ignaciosamba/PPS/informes/Informe200horas/tex/introduccion.tex

\section{Introducci\'on} % (fold)
\label{sec:introduccion}

Esta practica fue orientada al dise\~no y la construcci\'on de un sistema embebido que concentre las se\~nales de varios sensores y varias fuentes de eventos digitales. La idea es que un sistema embebido de uso especifico pueda tercerizar la tarea de obtener, convertir y procesar una se\~nal de uno o varios sensor o una o varias fuente de eventos digitales.

Este proyecto surgi\'o de la problem\'atica de algunos trabajos realizados dentro del Laboratorio de Arquitectura de Computadoras que compart\'ian el mismo inconveniente. La necesidad de un sistema que gen\'ericamente obtenga las se\~nales de los sensores y la pueda transmitir al sistema principal, ya convertidas. Adem\'as de un contador de eventos que no requiera del uso de interrupciones por software.

En este informe cubrimos los avances hechos en 200 horas de trabajo en el proyecto.
% section introducci\'on (end)
