ignaciosamba/PPS/informes/Informe 200 horas from Overleaf/practica-profesional-supervisada/tex/introduccion.tex

\section{Introducción} % (fold)
\label{sec:introduccion}

Esta práctica fue orientada al diseño y la construcción de un sistema embebido que concentre las señales de varios sensores y varias fuentes de eventos digitales. La idea es que un sistema embebido de uso específico pueda tercerizar la tarea de obtener, convertir y procesar una señal de uno o varios sensor o una o varias fuente de eventos digitales.

Este proyecto surgió de la problemática de algunos trabajos realizados dentro del Laboratorio de Arquitectura de Computadoras que compartían el mismo inconveniente. La necesidad de un sistema que genéricamente obtenga las señales de los sensores y la pueda transmitir al sistema principal, ya convertidas. Además de un contador de eventos que no requiera del uso de interrupciones por software.

En este informe cubrimos los avances hechos en 200 horas de trabajo en el proyecto.
% section introducción (end)
