ignaciosamba/PPS/informes/Informe 100 horas/tex/apendices/softwareUtilizado.tex

\section{Sofware Utilizado} % (fold)
\label{sec:sofware_utilizado}

\subsubsection{$\mu$Vision 4} % (fold)
\label{ssub:uvision_4}

$\mu$Vision 4 es un entorno de desarrollo de programacion desarrollado por KeilARM. Esta pensado para construccion de programas en C destinados a correr sobre sistemas embebidos, como es el caso de una Silicon Labs C8051F350. Confecciona todos los archivos fuente de un proyecto y los arma en un unico ejecutable, que luego puede cargarse al microcontrolador para su ejecucion. Tambien permite la opcion de debuggear. \\

\textbf{Mas informacion:}$\mu$Vision IDE Overview ( http://www.keil.com/uvision/default.asp )

% subsubsection uvision_4 (end)

\subsection{KiCad} % (fold)
\label{sub:kicad}

Kicad es una herramienta de software abierto que permite crear circuitos electronicos desde la etapa de dise\~no hasta la implementacion en circuito impreso. Permite la generacion de los archivos necesarios para generar la placa PCB impresa utilizando una fresadora o ruteadora.  \\

\textbf{Mas informacion:} KiCad EDA: A Cross Platform and Open Source Electronics Design Automation Suite ( http://kicad-pcb.org/help/documentation )

% subsection kicad (end)

% section sofware_utilizado (end)
