ignaciosamba/PPS/Placa Operacional/Impresion/herramientas.rtf

Perforación

Creado satisfactoriamente para las capas:
DrillUnplated

Atención, no hay objetos en las capas:
DrillPlated

Herramientas necesarias

Herramientas de perforación:
1 x Spiral Drill 1 mm ( 32 strokes )
1 x Spiral Drill 1,5 mm ( 5 strokes )
1 x Spiral Drill 1,8 mm ( 2 strokes )
1 x Spiral Drill 0,9 mm ( 29 strokes )

Fresa de contorneado:
1 x Contour Router 1 mm ( 11,2 mm )

Herramientas cónicas:
1 x Universal Cutter 0,2 mm ( 68,0 mm )
