ignaciosamba/PPS/informes/Informe 100 horas/main.tex

%%%%%%%%%%%%%%%%%%%%%%%%%%%%%%%%%%%%%%%%%%%%%%%%%%%%%%%%%%%%%%%%%%%%%%%%%%%
%
% Plantilla para un artículo en LaTeX en espa\~nol.
%
%%%%%%%%%%%%%%%%%%%%%%%%%%%%%%%%%%%%%%%%%%%%%%%%%%%%%%%%%%%%%%%%%%%%%%%%%%%

\documentclass{article}

% Esto es para poder escribir acentos directamente:
\usepackage[utf8]{inputenc}
\inputencoding{latin1}

% Esto es para que el LaTeX sepa que el texto está en espa\~nol:
\usepackage[spanish]{babel}
% Esto es para que se pueda crear el indice
%\usepackage{makeidx}
% Paquetes de la AMS:
\usepackage{amsmath, amsthm, amsfonts}
% para poder poner una hoja apaisada
\usepackage{lscape}
%para incluir graficos
\usepackage{graphicx}
%para permitir que la imagen este donde yo quiero y no en otro lugar
\usepackage{float}
% para hipertexto
\usepackage{url}
% para poder envolver imagenes con texto
\usepackage{wrapfig}
%para los apendices
\usepackage[titletoc]{appendix}
% Esto es para poder modificar las dimensiones del texto
\usepackage{geometry}
\geometry{a4paper}

% Paquetes de la AMS:
\usepackage{amsmath, amsthm, amsfonts}

\graphicspath{ {Imagenes/} }

% Teoremas
%--------------------------------------------------------------------------
\newtheorem{thm}{Teorema}[section]
\newtheorem{cor}[thm]{Corolario}
\newtheorem{lem}[thm]{Lema}
\newtheorem{prop}[thm]{Proposición}
\theoremstyle{definition}
\newtheorem{defn}[thm]{Definición}
\theoremstyle{remark}
\newtheorem{rem}[thm]{Observación}

% Atajos.
% Se pueden definir comandos nuevos para acortar cosas que se usan
% frecuentemente. Como ejemplo, aquí se definen la R y la Z dobles que
% suelen representar a los conjuntos de números reales y enteros.
%--------------------------------------------------------------------------

\def\RR{\mathbb{R}}
\def\ZZ{\mathbb{Z}}

% De la misma forma se pueden definir comandos con argumentos. Por
% ejemplo, aquí definimos un comando para escribir el valor absoluto
% de algo más fácilmente.
%--------------------------------------------------------------------------
\newcommand{\abs}[1]{\left\vert#1\right\vert}
\newcommand{\summary}[1]{\addtocontents{toc}{#1\par}}

% Operadores.
% Los operadores nuevos deben definirse como tales para que aparezcan
% correctamente. Como ejemplo definimos en jacobiano:
%--------------------------------------------------------------------------
\DeclareMathOperator{\Jac}{Jac}

%--------------------------------------------------------------------------
\title{\underline{Practica Profesional Supervisada} \\
\large \underline{Informe de las 100 horas} \\
\huge \textbf{ \\ Plataforma Concentradora de Sensores y Eventos Digitales} \\ }
\author{Autores: Ignacio Sambataro, Luciano Mantovani\\ \\
  \large Tutor: PhD. Ing. Orlando Micolini \\
  \large Supervisor: Ing. Maximiliano Eschoyez
 % \small Facultad de Ciencias Exactas, Fisicas y Naturales\\
 % \small Laboratorio de Arquitectura de Computadoras\\
 % \small Universidad Nacional de Cordoba\\
  \date{}
}

%\makeindex
\begin{document}
\maketitle
\begin{figure}[H]
\centering

\end{figure}

\begin{center}
\small Facultad de Ciencias Exactas, Físicas y Naturales
\end{center}

\begin{center}
\small Laboratorio de Arquitectura de Computadoras
\end{center}

\begin{center}
\small Año 2015 \\
\end{center}

%resumen
\abstract{En este informe se describen las primeras 100 horas de trabajo de la Práctica Profesional Supervisada. Se comenzó un proyecto nuevo, sugerido por el director, Orlando Micolini, y se trabajo todo el tiempo en el Laboratorio de Arquitectura de Computadoras. Se documentaron los requerimientos, la etapa de investigación, los diseños de hardware y software hasta el momento, y las implementaciones que se llegaron a lograr. Lo que se llego a implementar se hizo en una placa de desarrollo prestada. Las razones de utilización de esta placa se explican en el documento. Algunos requerimientos básicos llegaron a cumplirse dentro de las 100 horas, pero solamente prototipos de prueba en la placa de desarrollo. El primer prototipo real tiene la mayor parte del diseño de hardware y software hecho, pero todavía no esta implementado. }

%salto de pagina
\thispagestyle{empty}
\clearpage

\tableofcontents
\thispagestyle{empty}
\clearpage

\setcounter{page}{1}
%introduccion
\input{./tex/introduccion.tex}

%requerimientos
\input{./tex/requerimientos.tex}

%investigacion
\input{./tex/investigacion.tex}

%Silicon Labs C8051F352
\input{./tex/siliconlabs.tex}

%Diseño de Software
\input{./tex/softdesign.tex}

%Diseño de Hardware
\input{./tex/harddesign.tex}

%Estructura de Software
\input{./tex/softstruct.tex}

%Avances con respecto al diseño de hw y sw
\input{./tex/avances.tex}

%Proyecciones con respecto al futuro
\input{./tex/proyecciones.tex}

%conclusiones
\input{./tex/conclusiones.tex}

%Apendice
\input{./tex/appendix.tex}

%Bibliografia
\input{./tex/bibliografia.tex}

%\begin{equation}\label{eq:area}
%  S = \pi r^2
%\end{equation}
%Uno puede referirse a ecuaciones así: ver ecuación (\ref{eq:area}).
%También se pueden mencionar secciones de la misma forma: ver sección
%\ref{sec:nada}. O citar algo de la bibliografía: \cite{Cd94}.

\end{document}
