ignaciosamba/PPS/informes/Informe200horas/tex/requerimientos.tex

\section{Requerimientos}
\subsection{Principales}
\begin{itemize}
  \item Leer de 4 a 8 se\~nales anal\'ogicas y convertirlas a digital.
  \item Contar eventos con 3 o 4 contadores distintos.
  \item Transmitir los datos digitales a trav\'es de un protocolo serial a alguna otra placa o procesador.
\end{itemize}

\subsection{Secundarios}
\begin{itemize}
  \item Lograr el menor consumo posible.
  \item Buscar la mejor inmunidad al ruido, con una distancia de la placa a los sensores de hasta un m\'aximo de 10 metros.
  \item Lograr un producto lo m\'as peque\~no posible.
  \item Lograr un producto programable
\end{itemize}
