ignaciosamba/PPS/informes/Informe200horas/tex/softstruct.tex

\section{Estructura del software} % (fold)
\label{sec:estructura_del_software}

El programa esta dividido en 6 m\'odulos que en la mayor\'ia de los casos corresponde a cada bloque en el que esta dividido el sistema, como se muestra en la figura \ref{fig:bloques1}.

En este momento, el programa entero esta compuesto por 6 m\'odulos. Un modulo principal y otros 5 que definen funciones seg\'un los bloques que describen el comportamiento del sistema. El modulo principal ejecuta las funciones de los m\'odulos secundarios.

\paragraph{}
\textbf{Modulos:}
\begin{itemize}
  \item Principal
  \item Conversor
  \item Contador
  \item Interrupciones
  \item Configurador
  \item Interfaz de Usuario
\end{itemize}

\subsection{Configurador}\label{sec:configuradorsw}
El configurador se encarga de inicializar todos los par\'ametros necesarios que permiten la operatividad del resto de los m\'odulos. Establece los valores correspondientes para todos los registros pertinentes y configura los puertos seleccionados en el modulo del conversor (Secci\'on \ref{sec:conversorsw}) cuando se especifique por parte del usuario.
\subsection{Principal}
El modulo principal es la funci\'on main, inicializa todo el sistema usando funciones del configurador (Secci\'on \ref{sec:configuradorsw}) y hace el loop infinito que corre el sistema indefinidamente, obteniendo los comandos del usuario via la interfaz (Secci\'on \ref{sub:interfaz_de_usuario}).

\subsection{Conversor}\label{sec:conversorsw}
El modulo de conversi\'on se encarga de la etapa de obtenci\'on y procesado de las se\~nales convertidas del ADC (Secci\'on \ref{sub:conversor_anal\'ogico_digital}).

Las funciones de este modulo se encargan de que la obtenci\'on de los datos se corresponda con la configuraci\'on dada por el usuario. Es por esto que tiene funciones que se activan en la etapa de configuraci\'on del sistema que preparan al mismo para una obtenci\'on de datos conforme a los ajustes hechos por el usuario. Estos ajustes se realizan mediante las instrucciones MML mencionadas en la secci\'on \ref{sub:interfaz_de_usuario} y explicadas con detalle en el ap\'endice \ref{ap:instrucciones}.

\subsection{Interfaz de usuario} % (fold)
\label{sub:interfaz_de_usuario}

En un principio, se comenz\'o con una interfaz de usuario pensada en forma de un men\'u principal. La idea era que el usuario pueda acceder a todas las opciones de configuraci\'on del sistema desde este men\'u, ingresando opciones por teclado y cambiando as\'i los par\'ametros. La ventaja de este m\'etodo es que los errores por parte del usuario se reducen significativamente, dado que no tiene otra opci\'on que elegir entre las opciones que muestra el men\'u. La desventaja es la complejidad que implica hacer un sistema altamente configurable con una interfaz de este tipo. Esta desventaja fue finalmente la que hizo que se cambiara la interfaz por completo, ya que luego de algunas semanas, las opciones de configuraci\'on comenzaron a crecer y se hizo evidente que una interfaz de men\'u hacia la configuraci\'on muy engorrosa para el usuario y muy complicada de cambiar y hacer para el programador.Por lo que se cambio a un m\'etodo con mas libertades para el usuario y menos complejidad para el programador.

La interfaz de usuario actual esta hecha con un paradigma denominado "Man Machine Languaje". MML es un lenguaje de especificaci\'on que se usa t\'ipicamente para estandarizar la interfaz de un sistema para el manejo del mismo desde una consola. Siguiendo el paradigma de MML, lo que se hace es definir una serie de comandos que pueden aceptar una serie de argumentos. Con cada comando y sus argumentos se conforma una orden que ejecuta el procesador. De esta manera, se pueden lograr instrucciones simples que cambian distintos aspectos de la configuraci\'on del sistema conforme a las intenciones del usuario.

\subsection{Estructura de las instrucciones}

Todas las instrucciones siguen las mismas reglas. Una instrucci\'on puede ser un \'unico comando, o un comando y uno o varios argumentos.

\begin{equation}
	MML>COMANDO[,ARG1,ARG2,...]
\end{equation}

Arriba puede verse la estructura de una instrucci\'on. Una instrucci\'on puede tener argumentos, dependiendo de la funcionalidad a implementar. En caso que los tenga deben escribirse separados por comas. El prompt ``MML$>$'' indica que el sistema esta esperando una nueva instrucci\'on.

Una descripci\'on completa de las instrucciones hechas hasta el momento se encuentra en el ap\'endice \ref{ap:instrucciones}. Con esto, es posible configurar todos los aspectos del sistema, sabiendo como operan todas las instrucciones y sus argumentos.

% subsection interfaz_de_usuario (end)
\subsubsection{Modo de operaci\'on de la interfaz de usuario} % (fold)
\label{ssub:modo_de_operaci\'on_de_la_interfaz_de_usuario}

Cuando se inicia el sistema, se env\'ia un primate (``MML$>$'') por UART al dispositivo que este conectado del otro lado. Cada vez que se pueda leer un prompt, es porque el sistema esta esperando un comando. Con cada comando ingresado, hay un c\'odigo de error que se devuelve, que indica al usuario si la operaci\'on fue exitosa, y sino, que es lo que ocasiono que no lo sea.

\begin{figure}[h]
  \centering
  
  \caption{Ejemplo de uso instrucciones}\label{fig:instrucciones}
\end{figure}

En la figura \ref{fig:instrucciones} se muestra un caso de instrucciones ingresadas en el sistema. Cada instrucci\'on devuelve algo, ya sea una respuesta a una solicitud o un c\'odigo de respuesta, que puede incluir un error. Los detalles de las instrucciones ingresadas (SSE,SGA y SHA) se describen en el ap\'endice \ref{ap:instrucciones}.

% subsubsection modo_de_operacion_de_la_interfaz_de_usuario (end)

\subsection{Contador} % (fold)
\label{sub:contador}

El modulo de contador contiene funciones que devuelven los valores de las cuentas actuales de los contadores en funcionamiento. Por una cuesti\'on de simpleza, los contadores siempre est\'an activos, ya sea que se usen o no. Actualmente se cuenta con tres contadores de eventos. El microcontrolador tiene cuatro timers (Secci\'on\ref{sub:contadores}) pero obligadamente uno de ellos debe ser utilizado por el modulo de la interfaz serial UART (Secci\'on\ref{sub:interfaz_serial}).

Cada contador utilizable tiene una funci\'on que simplemente se encarga de obtener el valor de la cuenta en su respectivo timer asociado. Las instrucciones definidas en MML(Secci\'on \ref{sub:interfaz_de_usuario}) descriptas en el ap\'endice \ref{ap:instrucciones} incluyen las instrucciones GT0, GT1, y GT2, que se utilizan para la obtenci\'on del valor de la cuenta actual.
% subsection contador (end)

\subsection{Interrupciones} % (fold)
\label{sub:interrupciones}

Este archivo define las rutinas de interrupci\'on para aquellas funcionalidades que se requiere que realicen interrupciones sobre el microcontrolador para condicionar el comportamiento del programa. El conversor anal\'ogico-digital (Secci\'on \ref{sub:conversor_anal\'ogico_digital}) es el \'unico modulo que realiza interrupciones.

% subsection interrupciones (end)

\clearpage

% section estructura_del_software (end)
