ignaciosamba/PPS/informes/CARTEL PARA BOX.docx

PROYECTO INTEGRADOR

Sistema inteligente de detección de campo electrostático atmosférico.

Luciano Mantovani - lucianomanto@gmail.com - 3513922584

Ignacio Sambataro - ignaciosamba@gmail.com - 3513968990

Horarios: Lunes a viernes. Turno tarde
