ignaciosamba/PPS/UML y diseño/Descripcion de casos de uso del sistema.xlsx

Sheet: Hoja1
tabla de caso de uso para el caso de enviar comandos
Pre-Condicion | Sistema 8051 iniciado.
 | Sistema 8051 preparado para recibir comandos
Post-Condicion | Comando enviado.
 | Sistema Rpi en espera de un codigo de error
Flujo normal
 | 1. Prepara el comando
 | 2. Envia el comando por UART
 | 3. Se coloca en modo de recepcion para recibir el codigo de error.

Sheet: Hoja2
tabla de caso de uso para el modo de recepcion continua de mediciones
Pre-Condicion | Sistema 8051 iniciado.
 | Sistema 8051 preparado para recibir comandos
 | Parametros de los pines de medicion y ganancia seteados (ganancia puede estar en 0)
Post-Condicion | El sistema 8051 esta en modo de transmision continua de datos medidos
 | Sistema Rpi entro en modo de recepcion continua de mediciones
Flujo normal
 | 1. El comando "ST" se envia desde el sistema Rpi al sistema 8051 por UART
 | 2. Espera el codigo de error
 | 3. Se coloca en modo de recepcion para recibir mediciones
Flujo alternativo | 2.1 El codigo de error devuelve un error
obs | La post-condicion del flujo alternativo es que se resuelve el error antes de proseguir con los pasos siguientes

Sheet: Hoja3
tabla de caso de uso para el modo de recepcion continua de mediciones
Pre-Condicion | Sistema 8051 iniciado.
 | Sistema 8051 preparado para recibir comandos
 | Parametros de los pines de medicion y ganancia seteados (ganancia puede estar en 0)
Post-Condicion | El sistema 8051 esta en modo de transmision continua de datos medidos
 | Sistema Rpi entro en modo de recepcion continua de mediciones
Flujo normal
 | 1. El comando "ST" se envia desde el sistema Rpi al sistema 8051 por UART
 | 2. Espera el codigo de error
 | 3. Se coloca en modo de recepcion para recibir mediciones
Flujo alternativo | 2.1 El codigo de error devuelve un error
obs | La post-condicion del flujo alternativo es que se resuelve el error antes de proseguir con los pasos siguientes
