ignaciosamba/PPS/informes/tablas.xlsx

PRUEBAS DEL ADC
Pruebas del adc en el programa viejo
Pins | modo | OWR teorico | OWR real | Obs
0 | single | 20 | 22.73
1 | single | 20 | 22.22
2 | single | 20 | 7.46
3 | single | 20 | 7.46
4 | single | 20 | 7.46
5 | single | 20 | 21,74/5,68 | 2 frecuencias
6 | single | 20 | 22.76
7 | single | 20 | 11.24
0.1 | dif | 20 | 21,74/5,68 | 2 frecuencias
2.3 | dif | 20 | 11.36
4.5 | dif | 20 | 7.57
6.7 | dif | 20 | 22,73/5,68 | 2 frecuencias
Prueba de saturacion de la frecuencia de muestreo con respecto al delay del programa
sin procesamiento en el medio |  |  | con el programa viejo
OWR teorico | OWR real |  | OWR teorico | OWR real
20 | 22.73 |  | 20 | 22.73
30 | 34.48 |  | 30 | 34.48
50 | 56.82 |  | 50 | 14.29
100 | 113.6 |  | 100 | 0
1000 | 1136 |  | 1000 | 0
9000 | 11360 |  | 9000 | 0
10000 | 0 |  | 10000 | 0
