ignaciosamba/PPS/Cosas del sistema del SE/475710928_o.jpg

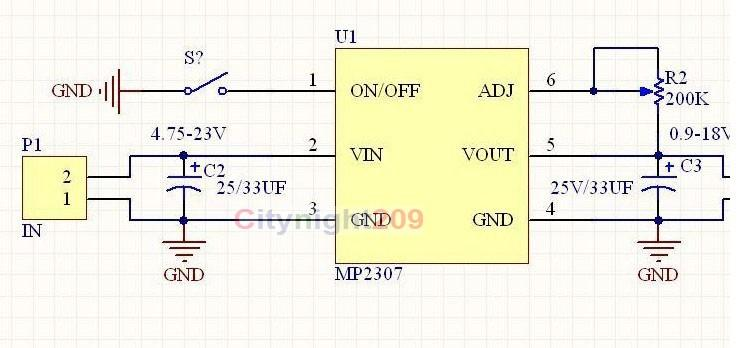
Cosas del sistema del SE/475710928_o.jpg
