ignaciosamba/PPS/Diagramas StarUML/Activity Activity diagram con el buffer.png

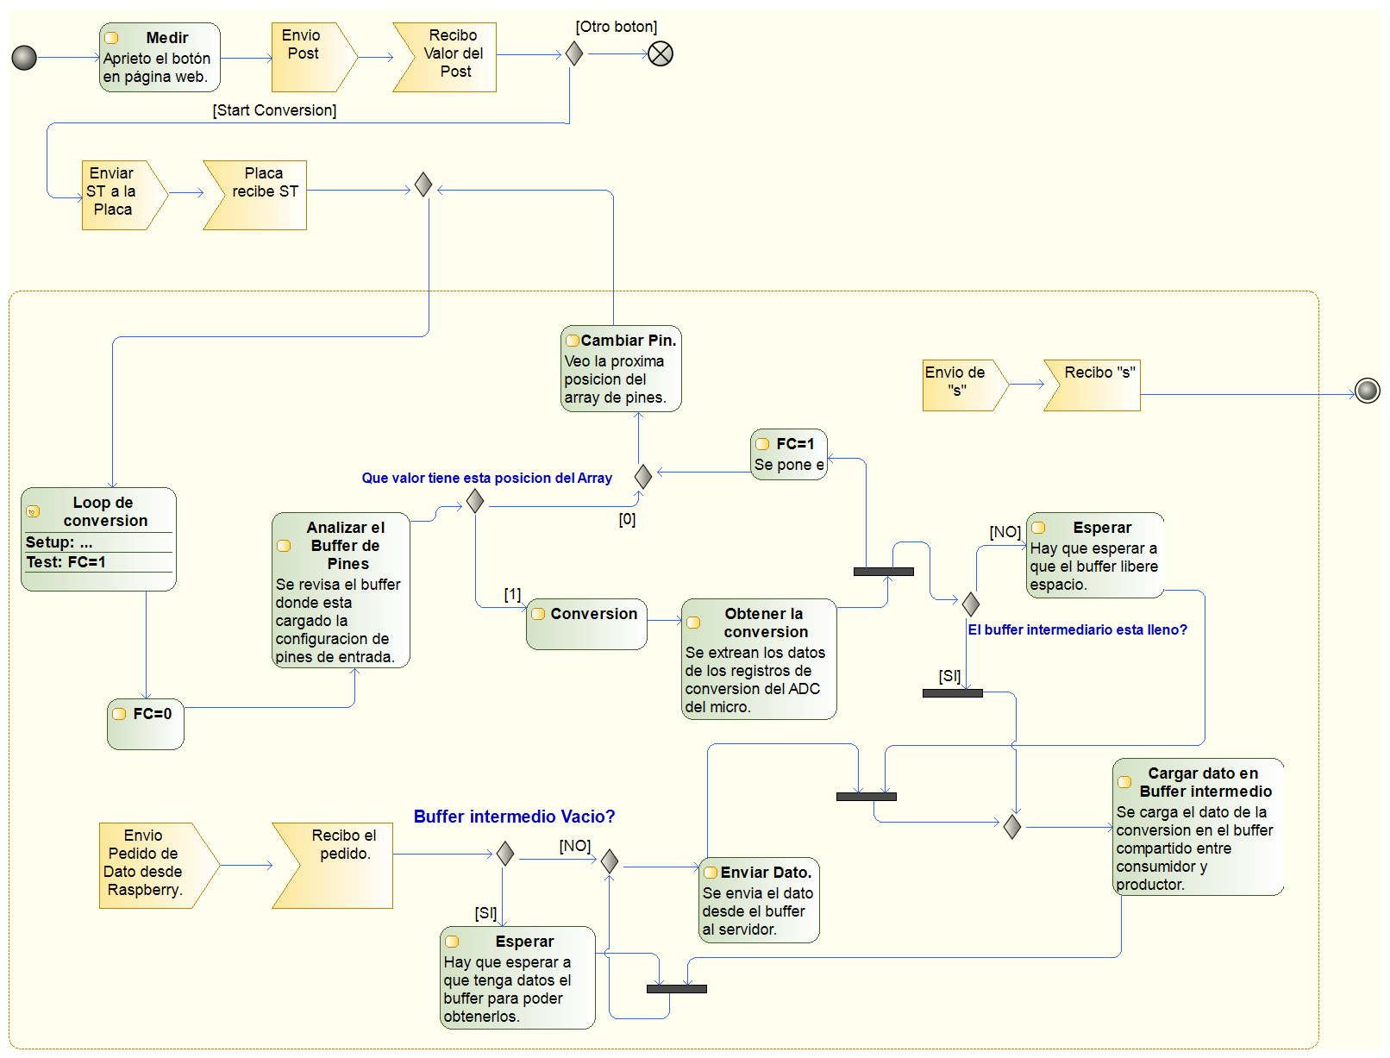
Diagramas StarUML/Activity Activity diagram con el buffer.png
