ignaciosamba/PPS/informes/Informe200horas/Imagenes/Bloques1.jpg

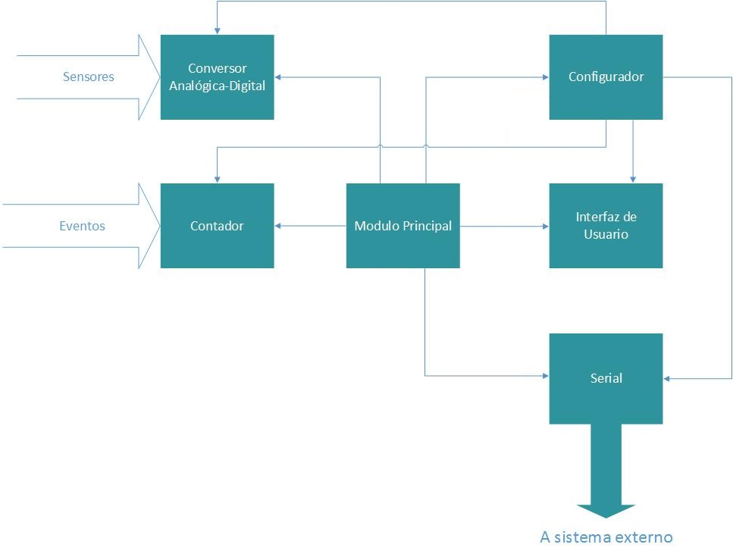
informes/Informe200horas/Imagenes/Bloques1.jpg
