ignaciosamba/PPS/informes/Informe200horas/Imagenes/ddflujoAnalizarBuffer.jpg

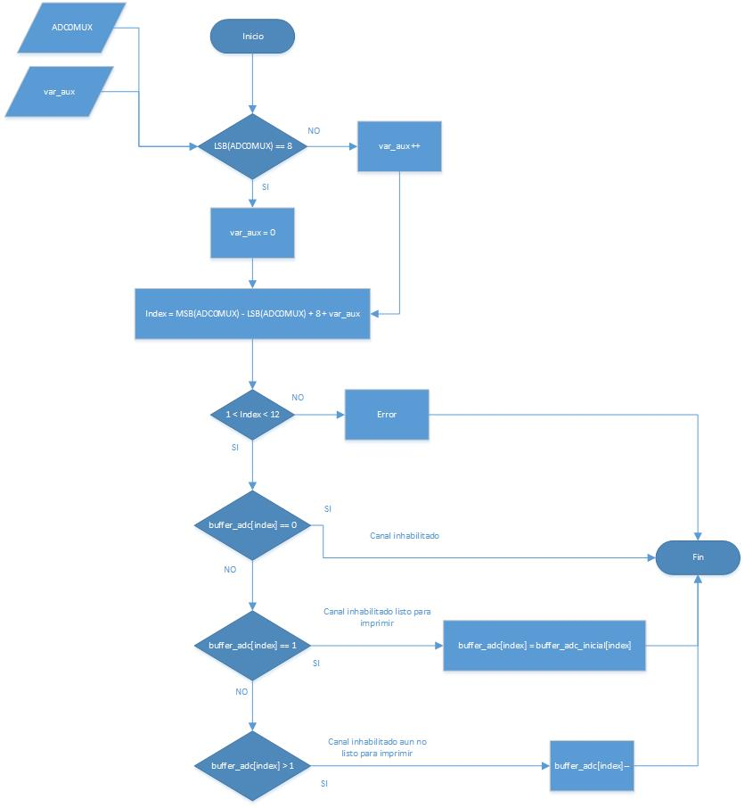
informes/Informe200horas/Imagenes/ddflujoAnalizarBuffer.jpg
