ignaciosamba/PPS/informes/Informe200horas/Imagenes/ddflujoCambiarPin.jpg

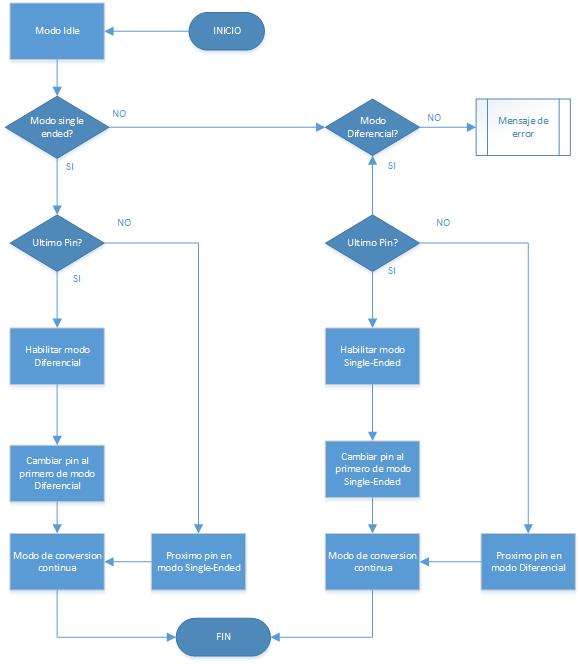
informes/Informe200horas/Imagenes/ddflujoCambiarPin.jpg
