ignaciosamba/PPS/informes/Informe200horas/Imagenes/placa1.jpg

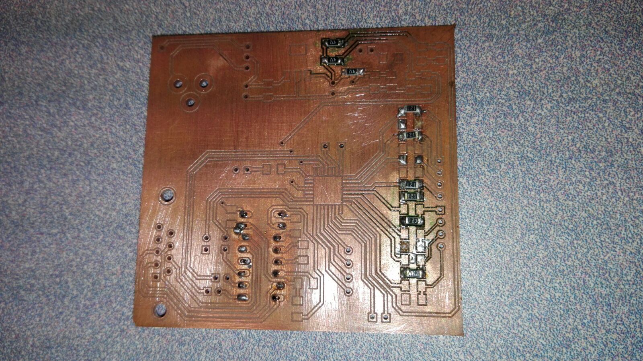
informes/Informe200horas/Imagenes/placa1.jpg
