ignaciosamba/PPS/informes/Informe 100 horas/Imagenes/placa1.jpg

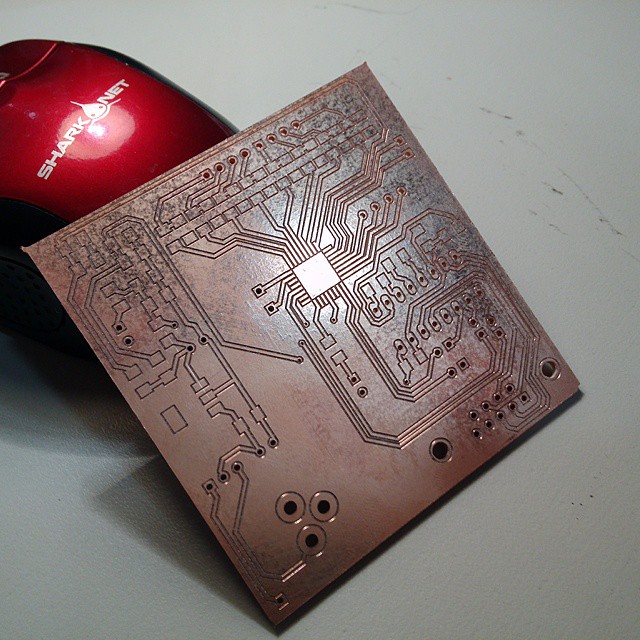
informes/Informe 100 horas/Imagenes/placa1.jpg
