ignaciosamba/PPS/Placa Operacional/Operacional.png

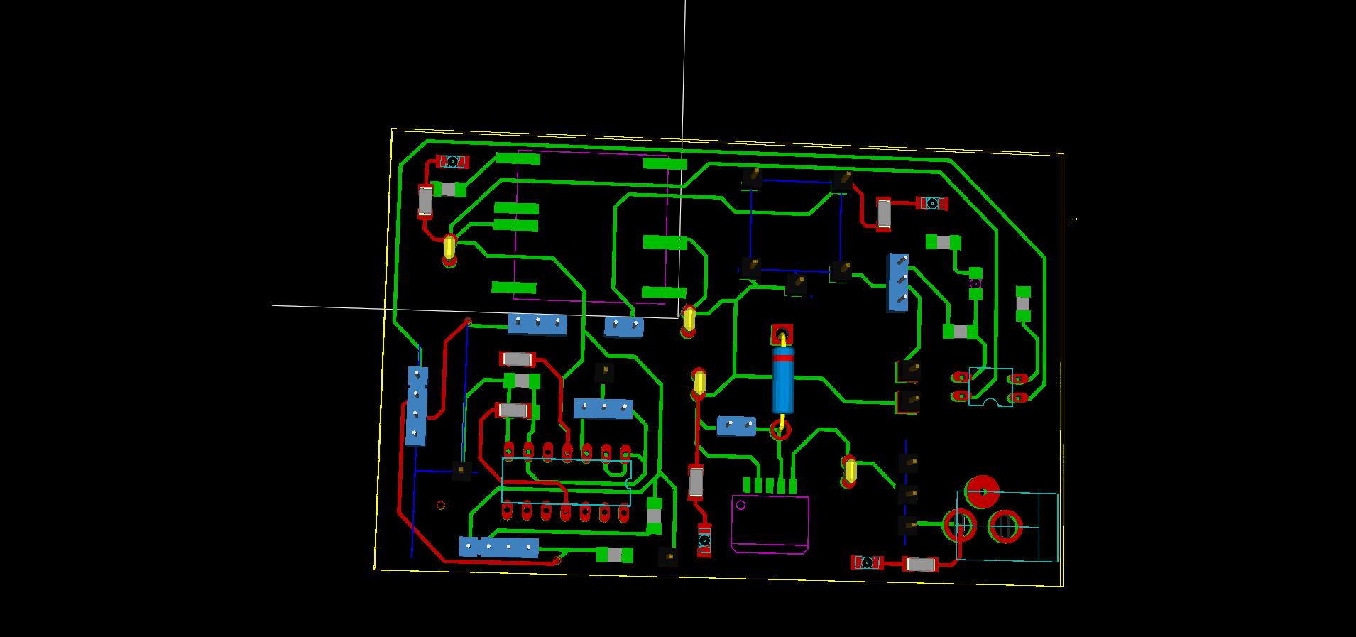
Placa Operacional/Operacional.png
