ignaciosamba/PPS/Placa/Captura.PNG

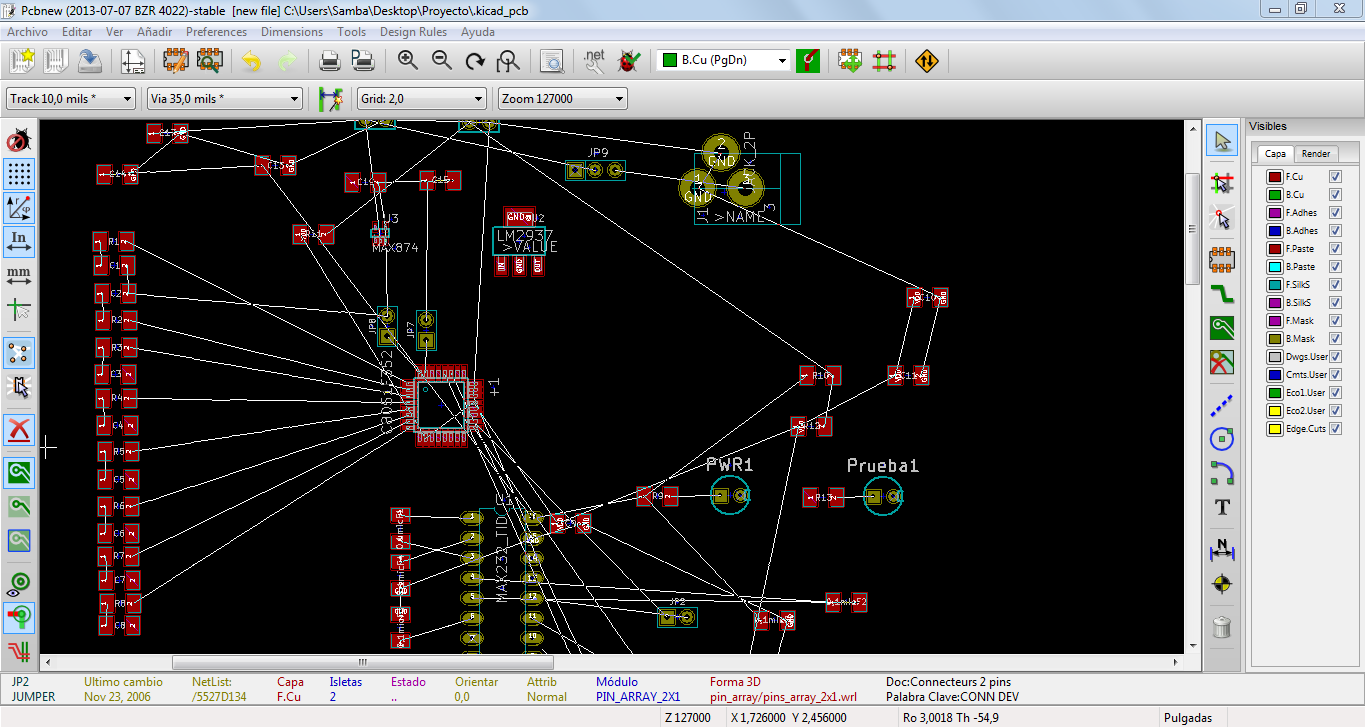
Placa/Captura.PNG
