ignaciosamba/PPS/Placa/Placa2.PNG

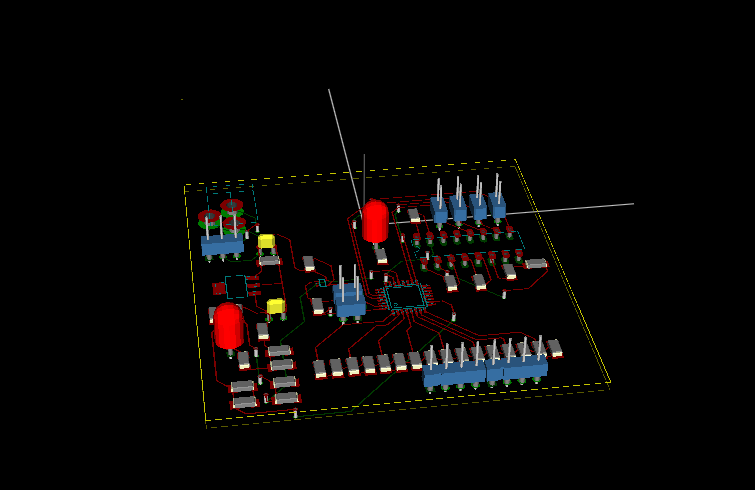
Placa/Placa2.PNG
