ignaciosamba/PPS/Placa/Placa3.PNG

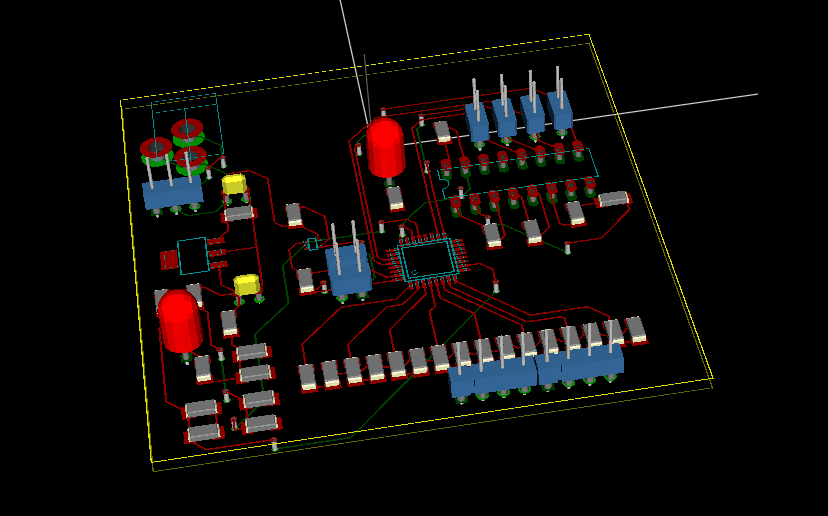
Placa/Placa3.PNG
