ignaciosamba/PPS/Placa/placa 1.PNG

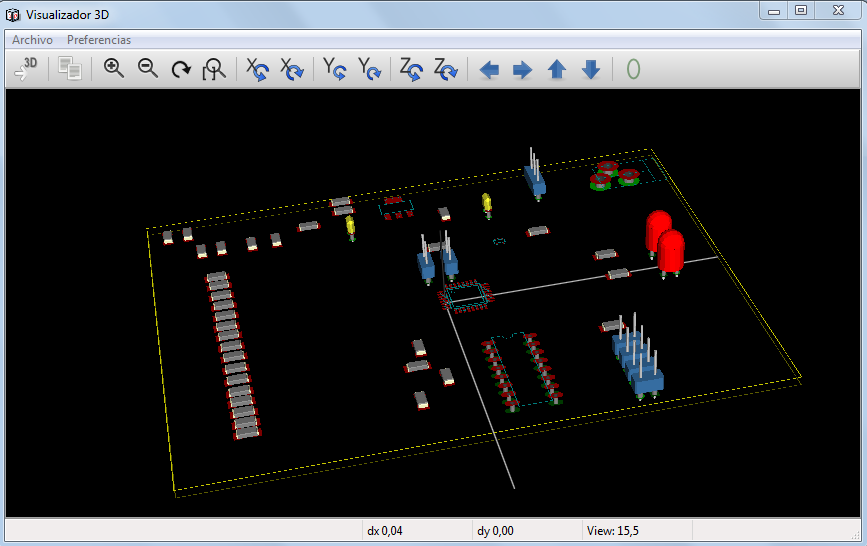
Placa/placa 1.PNG
