ignaciosamba/PPS/ranurada.png

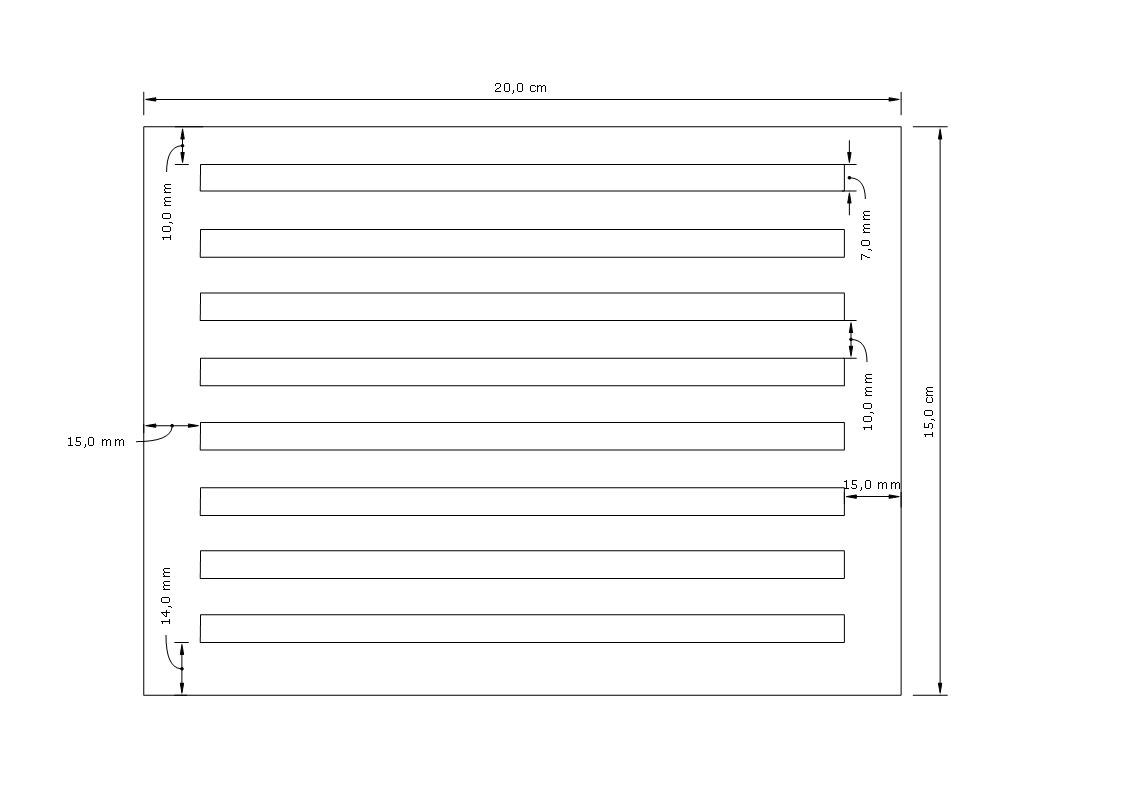
ranurada.png
