ignaciosamba/PPS/informes/Informe 100 horas/tex/apendices/componentesElectronicos.tex

\section{Componentes Electronicos Utilizados} % (fold)
\label{sec:componentes_electronicos_utilizados}

% \subsection{Optoacoplador T2103} % (fold)
% \label{ssub:optoacoplador_t2103}

% subsubsection optoacoplador_t2103 (end)

\subsection{Regulador de Tension LM2937} % (fold)
\label{sub:regulador_de_tension_lm2937}

Es un regulador de tension positivo capaz de soportar una corriente de carga de 500mA. Desarrollado por Texas Instruments. Ideal para aplicaciones de automatizacion. Tiene proteccion intrinseca contra corrientes inversas, y proteccion contra cortocircuitos. \\

\textbf{Mas informacion:} http://www.ti.com/lit/ds/symlink/lm2937.pdf

% subsection regulador_de_tension_lm2937 (end)

\subsection{Driver MAX232} % (fold)
\label{sub:driver_max232}

Es un driver receptor/emisor que incluye un voltaje capacitivo generador para proveer voltajes a niveles TTL de una alimentacion de 5V. Un receptor convierte entradas de tipo s TIA/EIA-232-F a niveles TTL/CMOS. Tiene una histeresis tipica de 0.5V. \\

\textbf{Mas informacion:} http://www.ti.com/lit/ds/symlink/max232.pdf

% subsection driver_max232 (end)

% section componentes_electronicos_utilizados (end)
