ignaciosamba/PPS/(list of files, cad)

Other CAD files:
sensorNuevo.skp
sensorNuevoed2.skp
