ignaciosamba/PPS/sanity & smoke tests/Prender motor.xlsx

Sheet: DESCRIPTION
Test case attributes
Test case # | 2
Test case name | Probar funcionamiento del motor
System | Placa de adquisicion con sensor de campo electrostatico
Subsystem | Placa complementaria del sensor
Designed by | Luciano Mantovani
Design date | 2016-05-04
Executed by
Execution date
Short description | Testea que el motor prenda y gire de manera estable, por 2 minutos enteros, sin pararse ni desestabilizarse de manera critica.
Pre-condiciones | •Sistema Raspberry Pi y 8051 prendidos y conectados
Post-condiciones | •Motor apagado •Sistema activo, esperando respuesta

Sheet: STEPS
Step | Action | Expected system response | Pass/Fail | Comment
1 | Pulsar el boton "ON" en la interfaz web | Se envia el comando exitosamente, y se guarda en la base de datos el comando enviado con la respuesta | fail
2 | El sistema 8051 dispara la funcion que prende el motor | Luego de los "bips" de control, el motor deberia arrancar y quedarse en un nivel estable | fail
3 | Esperar 2 minutos enteros | El motor deberia quedar en una velocidad estable y no deberia aumentar o disminuir la velocidad sobrepasando los niveles criticos. No deberia apagarse en los 2 minutos que esta funcionando | fail
4 | Pulsar el boton "OFF" en la interfaz web | Se envia el comando exitosamente, y se guarda en la base de datos el comando enviado con la respuesta | fail
5 | El sistema 8051 dispara la funcion que apaga el motor | El motor deberia apagarse. No se deberian escuchar los "bips" de control. Luego de esto el sistema 8051 y Raspberry, ambos deben quedar receptivos para un proximo comando | fail
