ignaciosamba/PPS/sanity & smoke tests/Probar conectividad.xlsx

Sheet: DESCRIPTION
Test case attributes
Test case # | 1
Test case name | Probar conectividad
System | Placa de adquisicion con sensor de campo electrostatico
Subsystem | Interfaces de comunicacion de Raspberry Pi y 8051
Designed by | Luciano Mantovani
Design date | 2016-05-04
Executed by
Execution date
Short description | Se comprueba la conectividad total entre la raspberry pi y el sistema 8051, comprobando que desde la pagina web levantada por el servidor en la Rbpi, se pueda efectivamente enviar y recibir datos hacia y desde el sistema 8051.
Pre-condiciones | •Rbpi y 8051 iniciados y conectados via wifi y UART
Post-condiciones | •Mensaje de respuesta que confirma el envio y recepcion del mensaje enviado •Sistema activo, esperando respuesta

Sheet: STEPS
Step | Action | Expected system response | Pass/Fail | Comment
1 | Escribir "SGA,3" en el espacio asignado en la interfaz de usuario en la pagina web para enviar un comando | mensaje en el log que indique que el mensaje fue enviado | Fail | No va a pasar hasta que no este implementado el log
2 | Recibir respuesta del comando en la UART de la Raspberry | La respuesta al comando deberia ser valida, indicando que se seteo la ganancia del conversor en "3" | Fail
