ignaciosamba/PPS/sanity & smoke tests/template/Excel template.xlsx

Sheet: DESCRIPTION
Test case attributes
Test case #
Test case name
System
Subsystem
Designed by
Design date
Executed by
Execution date
Short description
Pre-condiciones
Post-condiciones

Sheet: STEPS
Step | Action | Expected system response | Pass/Fail | Comment
