ignaciosamba/PPS/sanity & smoke tests/template/Test-case-template ref.txt

http://faculty.ksu.edu.sa/ghazy/CSC342_Tools/Test%20Case%20Template.pdf
