ignaciosamba/PPS/Source/test/test_files/test_interfaz_comandos_de_prueba.txt

SSE,245
PPP,2312
AAAA,123
AAAAASADS
AAA,123456789
