ignaciosamba/PPS/Placa Operacional/Operacional.kicad_pcb

## KiCad design Placa Operacional/Operacional.kicad_pcb (2016-03-21)

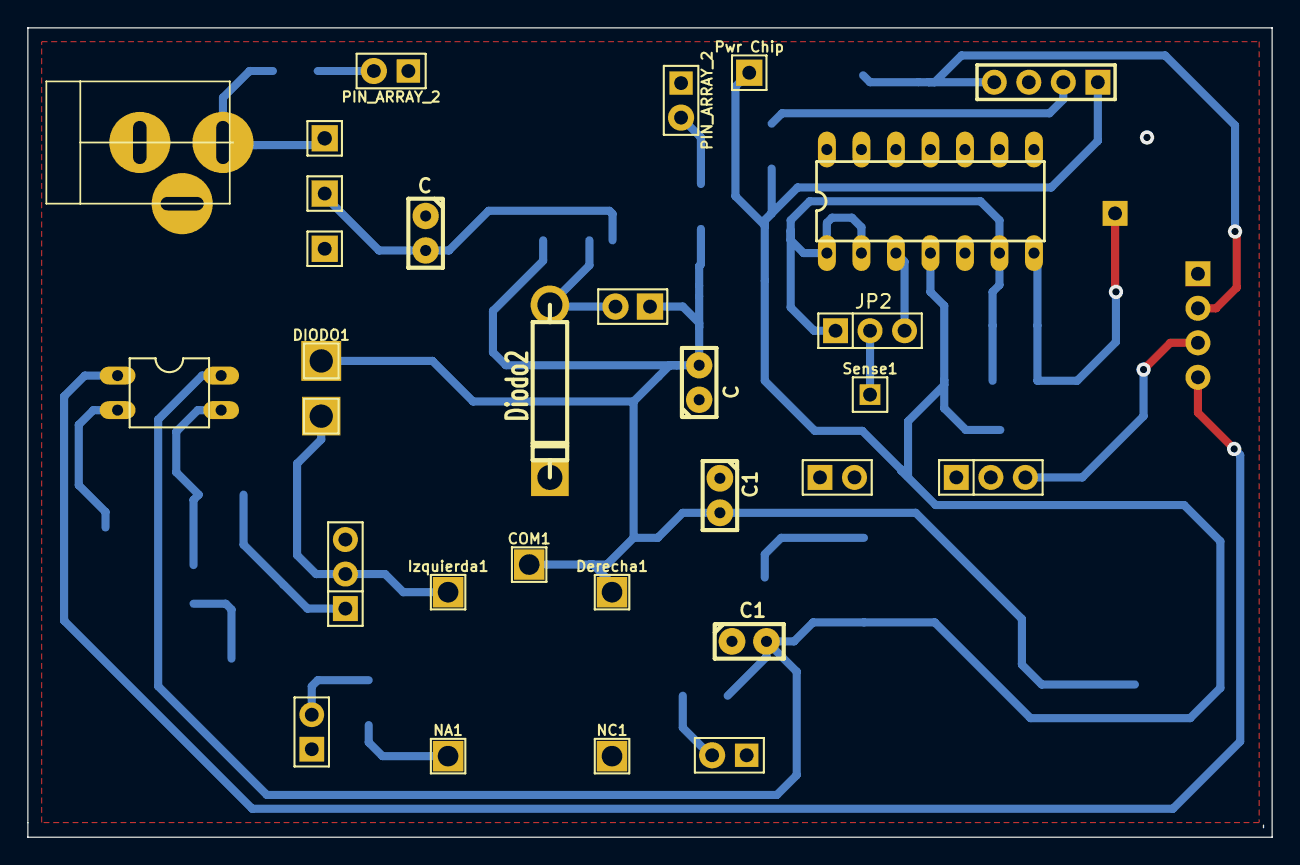
[picture p42: board Operacional.kicad_pcb from above]

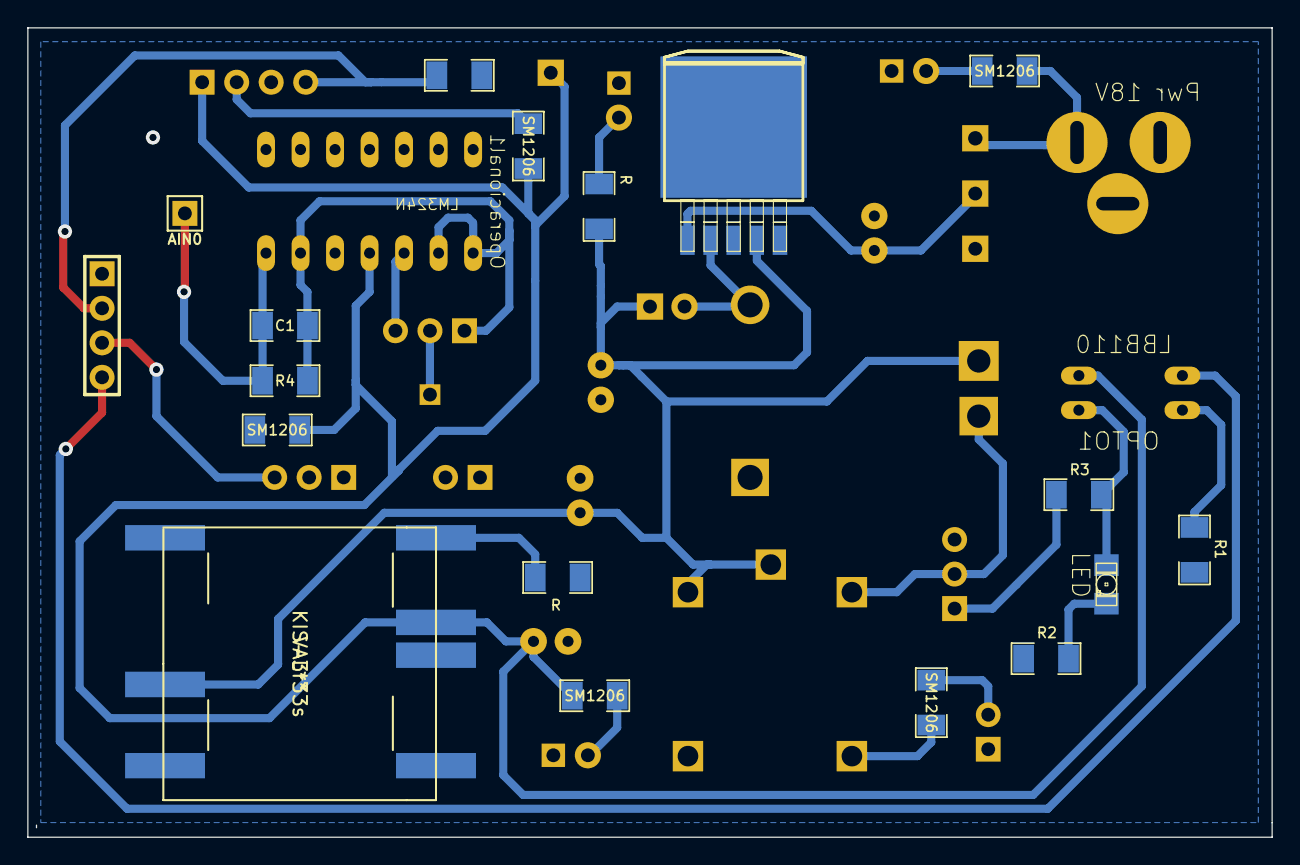
[picture p43: board Operacional.kicad_pcb from below]

Board: 2 copper layers, 91.6 x 59.6 mm, 32 parts (14 on the bottom side), 10 nets.

Parts:
AIN0: PIN_ARRAY_1
C: 100uF; C1
C1: 0.1uF; SM1206
C1#2, C1#3: C1
C#2: 1000uF; C1
COM1: PIN_ARRAY_1
DIODO1: PIN_ARRAY_1
Derecha1: PIN_ARRAY_1
Diodo2: D5
Izquierda1: PIN_ARRAY_1
JP2: PIN_ARRAY_3X1
KIS-3r33s: VAL**; KIS-3r33s
NA1: PIN_ARRAY_1
NC1: PIN_ARRAY_1
OPTO1: LBB110; optocoupler-2-DIL04
Operacional1: LM324N; op-amp-DIL14
PIN_ARRAY_2, PIN_ARRAY_2#2: Val**; PIN_ARRAY_2X1
Pwr Chip: PIN_ARRAY_1
R: 10K; SM1206
R1: 50; SM1206
R2: 1k; SM1206
R3, R4: 10k; SM1206
R#2: 1K; SM1206
SM1206, SM1206#2, SM1206#3, SM1206#4, SM1206#5: Val**; SM1206
Sense1: PIN_ARRAY_1

Connections:
GND: C.1, C1#2.1, C1#3.1, C#2.1, Diodo2.2, KIS-3r33s.2, KIS-3r33s.8, Operacional1.5, Operacional1.11, PIN_ARRAY_2.1, PIN_ARRAY_2#2.1, R.2, R1.2, R2.2, SM1206#5.2
unnamed: AIN0.1, C1.2, Operacional1.7, R4.2
unnamed: NA1.1, SM1206#3.1, SM1206#3.2
unnamed: C1.1, JP2.1, Operacional1.1, Operacional1.2, Operacional1.6, R4.1
unnamed: JP2.2, KIS-3r33s.5, R.1, Sense1.1
unnamed: JP2.3, Operacional1.3
unnamed: C.2, C1#2.2, C#2.2, COM1.1, DIODO1.1, Derecha1.1, Diodo2.1, KIS-3r33s.9, PIN_ARRAY_2.2, PIN_ARRAY_2#2.2, R#2.1, R#2.2, SM1206#2.1, SM1206#2.2
unnamed: OPTO1.2, R1.1
unnamed: OPTO1.3, R3.1
unnamed: C1#3.2, KIS-3r33s.4, OPTO1.4, Operacional1.4, Pwr Chip.1, SM1206.1, SM1206.2, SM1206#4.1, SM1206#4.2, SM1206#5.1
