ignaciosamba/PPS/Placa/PPS2.kicad_pcb

## KiCad design Placa/PPS2.kicad_pcb (2015-05-05)

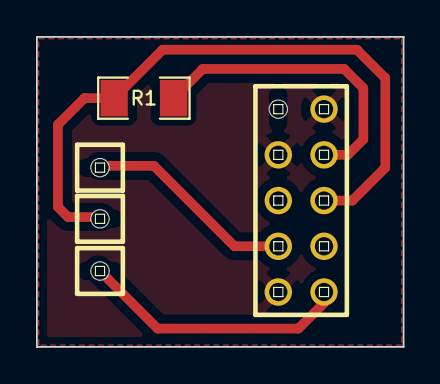
[picture p44: board PPS2.kicad_pcb from above]

Board: 2 copper layers, 20.4 x 17.2 mm, 5 parts (0 on the bottom side), 5 nets.

Parts:
C2CLK1, C2DATOS1: PINHD-1X1; pinhead-1X01
JP1: PINHD-2X5; pinhead-2X05
PIN1: PINHD-1X1; pinhead-1X01
R1: 1K; SM1206

Connections:
GNDPWR: JP1.2, JP1.3, JP1.9
unnamed: JP1.4, R1.2
unnamed: C2CLK1.1, JP1.7
unnamed: C2DATOS1.1, JP1.6, R1.1
unnamed: JP1.10, PIN1.1
