ignaciosamba/PPS/Placa/prueba1.kicad_pcb

## KiCad design Placa/prueba1.kicad_pcb (2015-04-20)

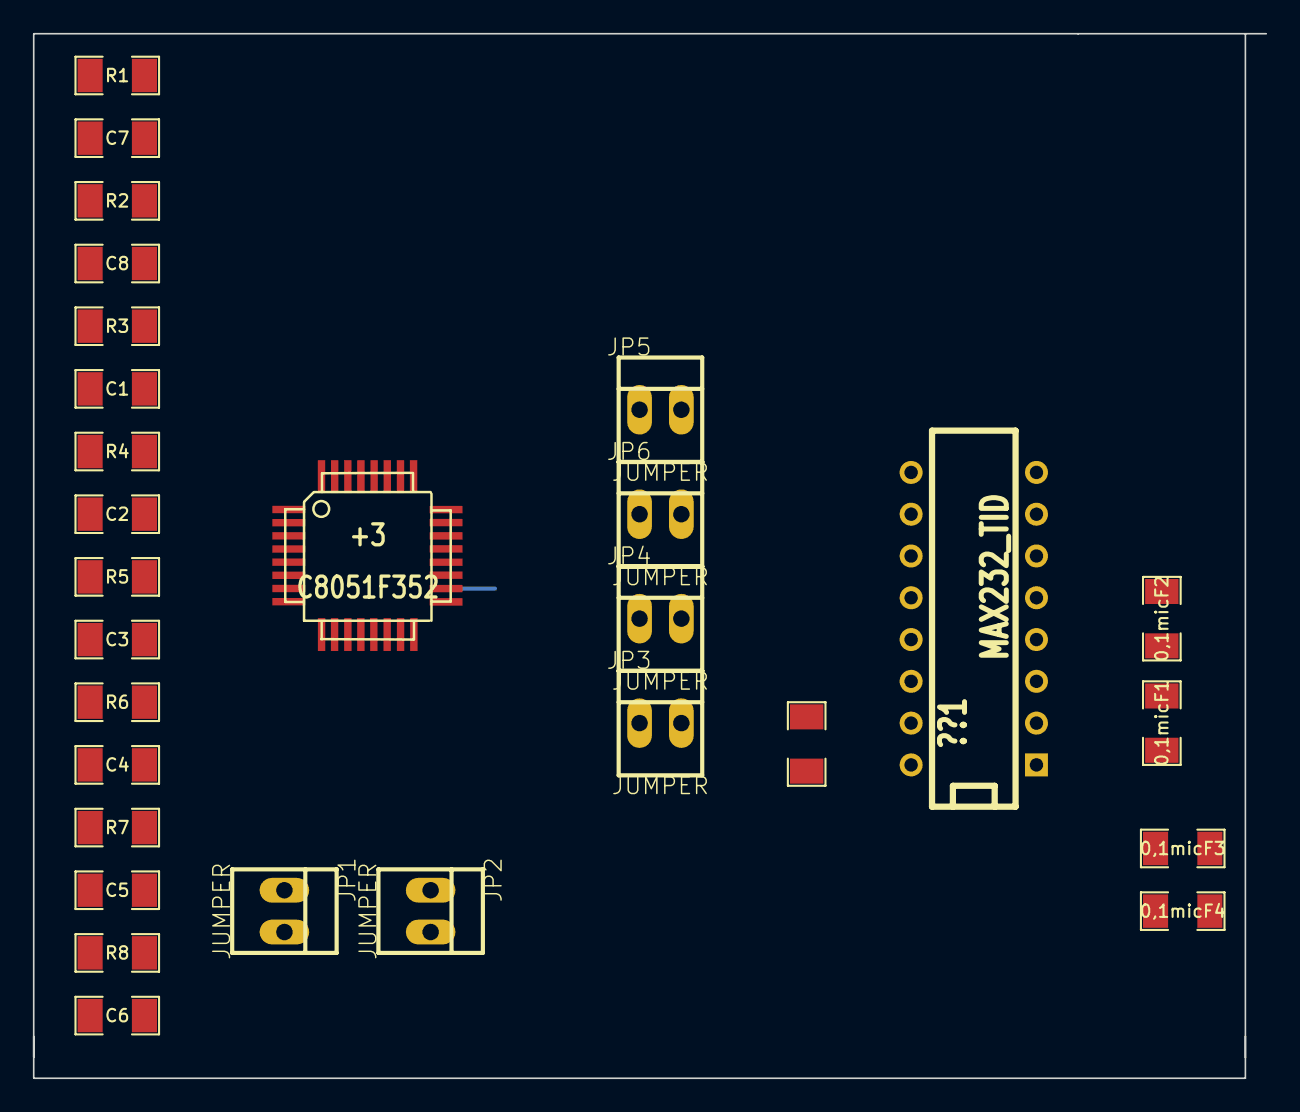
[picture p45: board prueba1.kicad_pcb from above]

Board: 2 copper layers, 74.9 x 63.5 mm, 29 parts (0 on the bottom side), 36 nets.

Parts:
0,1micF1: C8; SM1206
0,1micF2: C9; SM1206
0,1micF3: C12; SM1206
0,1micF4: C10; SM1206
0,1micF5: C11; SM1206
+3: C8051F352; TQFP32
??1: MAX232_TID; DIP-16__300
C1, C2, C3, C4, C5, C6, C7, C8: 0,1micF; SM1206
JP1, JP2, JP3, JP4, JP5, JP6: JUMPER; PINHEAD1-2
R1, R2, R3, R4, R5, R6, R7, R8: 100ohm; SM1206

Connections:
DGND: C7.2, C8.2
GND: 0,1micF3.2, 0,1micF4.2, 0,1micF5.2, ??1.15
unnamed: 0,1micF1.1, ??1.1
unnamed: 0,1micF1.2, ??1.3
unnamed: +3.18, JP4.1
unnamed: +3.17, JP3.1
unnamed: +3.27, JP6.1
unnamed: +3.12, JP2.1
unnamed: +3.11, JP1.1
unnamed: 0,1micF2.1, ??1.4
unnamed: 0,1micF2.2, ??1.5
unnamed: +3.6, R6.2
unnamed: +3.1, R1.2
unnamed: +3.2, R2.2
unnamed: +3.3, R3.2
unnamed: +3.4, R4.2
unnamed: +3.5, R5.2
unnamed: 0,1micF5.1, ??1.16
unnamed: +3.7, R7.2
unnamed: +3.28, JP5.1
unnamed: ??1.9, JP6.2
unnamed: ??1.10, JP5.2
unnamed: ??1.12, JP4.2
unnamed: ??1.11, JP3.2
unnamed: 0,1micF3.1, ??1.6
unnamed: 0,1micF4.1, ??1.2
unnamed: +3.8, R8.2
unnamed: C8.1, R2.1
unnamed: C7.1, R1.1
unnamed: C1.1, R3.1
unnamed: C2.1, R4.1
unnamed: C3.1, R5.1
unnamed: C4.1, R6.1
unnamed: C5.1, R7.1
unnamed: C6.1, R8.1
VDD: +3.10, +3.21
