ignaciosamba/PPS/Placa/PPS1.kicad_pcb.kicad_pcb

## KiCad design Placa/PPS1.kicad_pcb.kicad_pcb (2015-05-05)

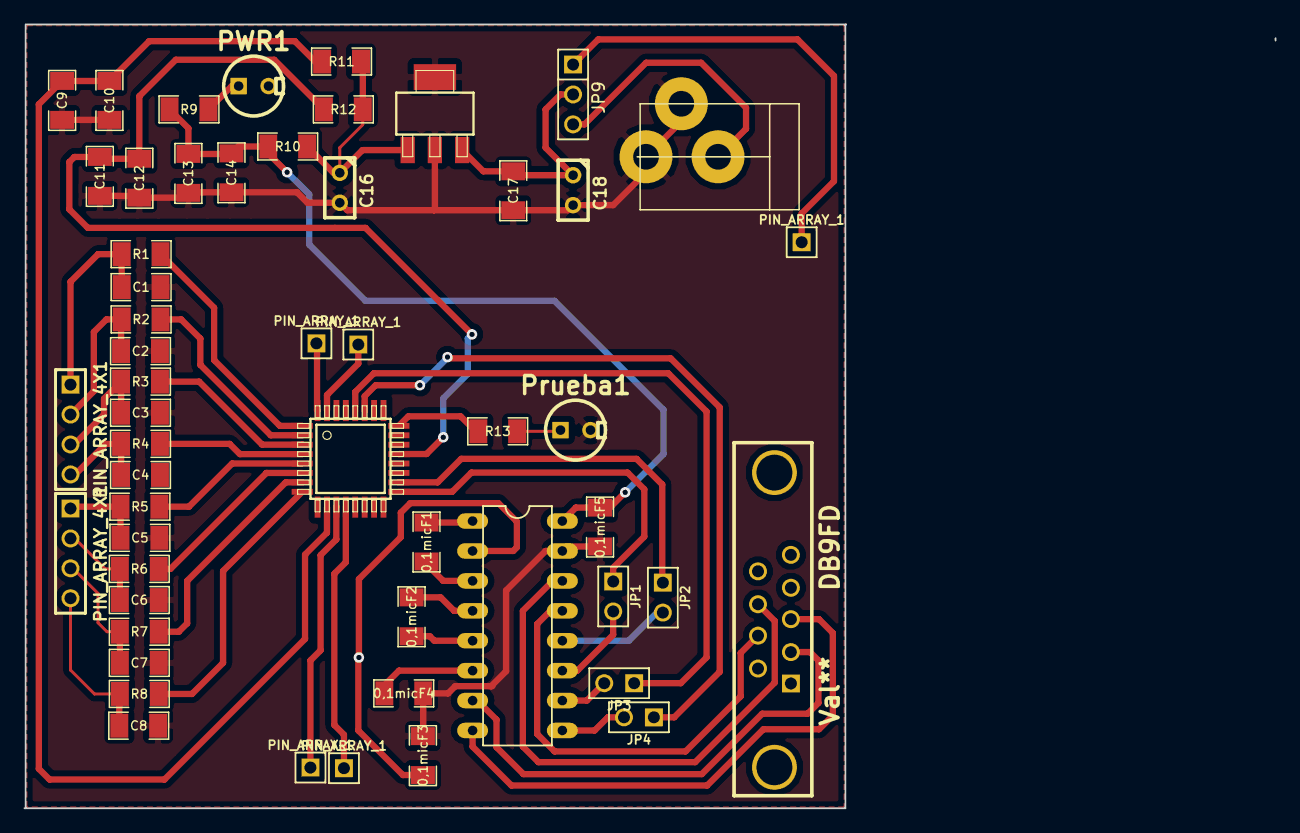
[picture p46: board PPS1.kicad_pcb.kicad_pcb from above]

Board: 2 copper layers, 69.7 x 66.5 mm, 54 parts (0 on the bottom side), 48 nets.

Parts:
0,1micF1: C8; SM1206
0,1micF2: C9; SM1206
0,1micF3: C12; SM1206
0,1micF4: C10; SM1206
0,1micF5: C11; SM1206
+1: C8051F352; micro-silabs-LQFP32
C1, C2, C3, C4, C5, C6, C7, C8, C9, C10, C12, C13, C14: 0,1micF; SM1206
C11: 1micF; SM1206
C16: 15uF; C1
C17: C; SM1206
C18: 10uF; C1
DB9FD: Val**; DB9FD
J1: JACK_2P; POWER-IN-JACK-PMS
JP1, JP2, JP3, JP4: JUMPER; PIN_ARRAY_2X1
JP9: JUMPER3; PIN_ARRAY_3X1
PIN_ARRAY_1, PIN_ARRAY_1#2, PIN_ARRAY_1#3, PIN_ARRAY_1#4, PIN_ARRAY_1#5: Val**; PIN_ARRAY_1
PIN_ARRAY_4X1, PIN_ARRAY_4X1#2: Val**; PIN_ARRAY_4x1
PWR1: LED; LEDV
Prueba1: LED; LEDV
R1, R2, R3, R4, R5, R6, R7, R8: 100ohm; SM1206
R9, R13: 470; SM1206
R10, R11, R12: 2.0; SM1206
U1: MAX232_TID; max232ti_n-DIL16
U2: LM2937; lm2937-SOT223

Connections:
+3.3V: 0,1micF5.1, C13.1, C14.1, R9.1, R10.1, U1.16
GND: 0,1micF3.2, 0,1micF4.2, 0,1micF5.2, +1.22, C1.2, C2.2, C3.2, C5.2, C6.2, C7.2, C8.2, C9.2, C10.2, C11.2, C12.2, C13.2, C14.2, C16.2, C17.2, C18.2, J1.1, J1.2, Prueba1.2, U1.15, U2.2, U2.GND@
unnamed: +1.28, JP3.1
unnamed: JP4.2, U1.9
unnamed: JP2.2, U1.12
unnamed: +1.27, JP4.1
unnamed: +1.18, JP2.1
unnamed: +1.17, JP1.1
unnamed: +1.3, +1.12, PIN_ARRAY_1#3.1, R3.2
unnamed: +1.7, R7.2
unnamed: +1.8, R8.2
unnamed: +1.11, PIN_ARRAY_1#2.1
unnamed: C17.1, C18.1, JP9.2, U2.3
unnamed: J1.3, JP9.3
unnamed: +1.32, PIN_ARRAY_1#4.1
unnamed: +1.31, PIN_ARRAY_1#5.1
unnamed: JP3.2, U1.10
unnamed: 0,1micF1.1, U1.1
unnamed: 0,1micF1.2, U1.3
unnamed: JP1.2, U1.11
unnamed: 0,1micF3.1, U1.2
unnamed: 0,1micF4.1, U1.6
unnamed: DB9FD.7, U1.13
unnamed: DB9FD.3, U1.8
unnamed: 0,1micF2.2, U1.5
unnamed: 0,1micF2.1, U1.4
unnamed: PWR1.1, R9.2
unnamed: JP9.1, PIN_ARRAY_1.1
unnamed: DB9FD.2, U1.7
unnamed: DB9FD.8, U1.14
unnamed: +1.24, R13.1
unnamed: Prueba1.1, R13.2
unnamed: C16.1, R10.2, R11.2, R12.2, U2.IN
unnamed: +1.4, R4.2
unnamed: C4.1, PIN_ARRAY_4X1.4, R4.1
unnamed: +1.1, R1.2
unnamed: C1.1, PIN_ARRAY_4X1.1, R1.1
unnamed: C5.1, PIN_ARRAY_4X1#2.1, R5.1
unnamed: +1.2, R2.2
unnamed: C2.1, PIN_ARRAY_4X1.2, R2.1
unnamed: C3.1, PIN_ARRAY_4X1.3, R3.1
unnamed: C8.1, R8.1
unnamed: C7.1, PIN_ARRAY_4X1#2.4, R7.1
unnamed: +1.6, PIN_ARRAY_4X1#2.3, R6.2
unnamed: C6.1, PIN_ARRAY_4X1#2.2, R6.1
unnamed: +1.5, R5.2
unnamed: +1.10, C9.1, C10.1, R11.1
VDD: +1.21, C11.1, C12.1, R12.1
