ignaciosamba/PPS/Source/fuentes/sensorCE/arrancar_motor.c

//-----------------------------------------------------------------------------
// F35x_PCA0_16Bit_PWM_Output.c
//-----------------------------------------------------------------------------
// Copyright 2006 Silicon Laboratories, Inc.
// http://www.silabs.com
//
// Program Description:
//
// This program sends a PWM waveform out of an I/O pin, using the PCA's
// 16-bit PWM Output Mode.  The duty cycle of the waveform is modified
// periodically within the main loop.
//
// In this example, PCA Module 0 is used to generate the waveform, and the
// crossbar is configured to send the CEX0 pin out on P0.0.
//
// How To Test:
//
// 1) Download code to a 'F35x device which has an oscilloscope monitoring P0.0
// 2) Run the program - the waveform should be visible on the oscilloscope.
// 3) Verify that the duty cycle of the waveform varies smoothly between
//    minimum and maximum values.
//
//
// FID:            35X000014
// Target:         C8051F35x
// Tool chain:     Keil C51 8.0 / Keil EVAL C51
// Command Line:   None
//
//
// Release 1.0
//    -Initial Revision (BD)
//    -3 AUG 2006
//

//-----------------------------------------------------------------------------
// Includes
//-----------------------------------------------------------------------------

#include <stdio.h>
#include "../headers.h"


//-----------------------------------------------------------------------------
// Global Constants
//-----------------------------------------------------------------------------

#define SYSCLK       24500000          // Internal oscillator frequency in Hz

//-----------------------------------------------------------------------------
// Function Prototypes
//-----------------------------------------------------------------------------

void OSCILLATOR_Init (void);
void PORT_Init (void);
void PCA0_Init (void);

//-----------------------------------------------------------------------------
// Global Variables
//-----------------------------------------------------------------------------

unsigned int CEX0_Compare_Value;       // Holds current PCA compare value

//-----------------------------------------------------------------------------
// main() Routine
//-----------------------------------------------------------------------------

void set_Pwm(unsigned int num);
void delay(int tiempo);

void main (void) 
{
   unsigned int delay_count;          // Used to implement a delay
   bit duty_direction = 0;             // 0 = Decrease; 1 = Increase

   PCA0MD = 0x00;                      // Disable watchdog timer

   PORT_Init ();                       // Initialize crossbar and GPIO
   OSCILLATOR_Init ();                 // Initialize oscillator
   PCA0_Init ();                       // Initialize PCA0

   // EA = 1;                             // Globally enable interrupts

   set_Pwm(42200);
   delay(600);
   set_Pwm(42100);
   delay(600);
   set_Pwm(33264);
   delay(600);
   set_Pwm(36000);
   // delay(600);
   // set_Pwm(32000);
   

while(1);

}


//-----------------------------------------------------------------------------
// Initialization Subroutines
//-----------------------------------------------------------------------------

//-----------------------------------------------------------------------------
// OSCILLATOR_Init
//-----------------------------------------------------------------------------
//
// Return Value : None
// Parameters   : None
//
// This function initializes the system clock to use the internal oscillator
// at 24.5 MHz.
//
//-----------------------------------------------------------------------------
void OSCILLATOR_Init (void)
{
   OSCICN = 0x83;                      // Set internal oscillator to run
                                       // at its maximum frequency

   CLKSEL = 0x00;                      // Select the internal osc. as
                                       // the SYSCLK source
}

//-----------------------------------------------------------------------------
// PORT_Init
//-----------------------------------------------------------------------------
//
// Return Value : None
// Parameters   : None
//
// This function configures the crossbar and GPIO ports.
//
// P0.0   digital   push-pull     PCA0 CEX0
//
//-----------------------------------------------------------------------------
void PORT_Init (void)
{
   XBR0    = 0x00;
   XBR1    = 0x41;                     // rutea CEX0 segun las prioridades del Xbar, por ahora P0.0
                                       // Enable crossbar and weak pull-ups

   P0MDOUT |= 0x01;                    // Set CEX0 (P0.0) to push-pull
}

//-----------------------------------------------------------------------------
// PCA0_Init
//-----------------------------------------------------------------------------
//
// Return Value : None
// Parameters   : None
//
// This function configures the PCA time base, and sets up 16-bit PWM output
// mode for Module 0 (CEX0 pin).
//
// The frequency of the PWM signal generated at the CEX0 pin is equal to the
// PCA main timebase frequency divided by 65536.
//
// The PCA time base in this example is configured to use SYSCLK, and SYSCLK
// is set up to use the internal oscillator running at 24.5 MHz.  Therefore,
// the frequency of the PWM signal will be 24.5 MHz / 65536 = 373.8 Hz.
// Using different PCA clock sources or a different processor clock will
// result in a different frequency for the PWM signal.
//
//    -------------------------------------------------------------------------
//    How "16-Bit PWM Mode" Works:
//
//       The PCA's 16-bit PWM Mode works by setting an output pin low every
//    time the main 16-bit PCA counter (PCA0H) overflows, and then setting
//    the pin high whenever a specific match condition is met.
//
//    Upon a PCA0 overflow (PCA0 incrementing from 0xFFFF to 0x0000), the
//    CEXn pin will be set low.
//
//    When the PCA0 register increments and matches the PCA0CPn register for
//    the selected module, the CEXn pin will be set high, except when the
//    ECOMn bit in PCA0CPMn is cleared to '0'.  By varying the value of the
//    PCA0CPn register, the duty cycle of the waveform can also be varied.
//
//    When ECOMn = '1', the duty cycle of the PWM waveform is:
//
//       16-bit PWM Duty Cycle = (65536 - PCA0CPn) / 65536
//
//    To set the duty cycle to 100%, a value of 0x0000 should be loaded into
//    the PCA0CPn register for the module being used (with ECOMn set to '1').
//    When the value of PCA0CPn is equal to 0x0000, the pin will never be
//    set low.
//
//    To set the duty cycle to 0%, the ECOMn bit in the PCA0CPMn register
//    should be cleared to 0.  This prevents the PCA0CPn match from occuring,
//    which results in the pin never being set high.
//
// When adjusting the PWM duty cycle, the low byte of the PCA0CPn register
// (PCA0CPLn) should be written first, followed by the high byte (PCA0CPHn).
// Writing the low byte clears the ECOMn bit, and writing the high byte will
// restore it.  This ensures that a match does not occur until the full
// 16-bit value has been written to the compare register.  Writing the high
// byte first will result in the ECOMn bit being set to '0' after the 16-bit
// write, and the duty cycle will also go to 0%.
//
// It is also advisable to wait until just after a match occurs before
// updating the PWM duty cycle.  This will help ensure that the ECOMn
// bit is not cleared (by writing PCA0CPLn) at the time when a match was
// supposed to happen.  This code implements the compare register update in
// the PCA ISR upon a match interrupt.
//    -------------------------------------------------------------------------
//
//-----------------------------------------------------------------------------
void PCA0_Init (void)
{
   // Configure PCA time base; overflow interrupt disabled
   PCA0CN = 0x00;                      // Stop counter; clear all flags
   PCA0MD = 0x08;                      // Use SYSCLK as time base

   PCA0CPM0 = 0xCB;                    // Module 0 = 16-bit PWM mode and
                                       // enable Module 0 Match and Interrupt
                                       // Flags

   EIE1 |= 0x10;                       // Enable PCA interrupts

   // Start PCA counter
   CR = 1;
}

/**
 * @brief cambia el ciclo de trabajo del PWM
 * @details con esta funcion se puede cambiar el ciclo de trabajo del pwm usando el registro PCA0CPL0 del PCA.
 * Cambia segun la funcion
 * 
 *  cdt = (65536 - PCA0CPn) / 65536
 * 
 * @param int [description]
 */
void set_Pwm(unsigned int num)
{

   EA = 1;
   while(CCF0 != 0);       // espera que termine el ciclo de trabajo
   EA = 0;

   // luego setea los valores
   PCA0CPL0 = (num & 0x00FF);
   PCA0CPH0 = (num & 0xFF00)>>8;


}



//-----------------------------------------------------------------------------
// End Of File
//-----------------------------------------------------------------------------


//-----------------------------------------------------------------------------
// PCA0_ISR
//-----------------------------------------------------------------------------
//
// Return Value : None
// Parameters   : None
//
// This is the ISR for the PCA.  It handles the case when a match occurs on
// channel 0, and updates the PCA0CPn compare register with the value held in
// the global variable "CEX0_Compare_Value".
//
//-----------------------------------------------------------------------------
// void PCA0_ISR (void) interrupt 11
// {
//    CCF0 = 0;                           // Clear module 0 interrupt flag.

//    PCA0CPL0 = (CEX0_Compare_Value & 0x00FF);
//    PCA0CPH0 = (CEX0_Compare_Value & 0xFF00)>>8;
// }


void delay(int tiempo)
{
	int i = 0;
	EA = 1;
	while(1)
	if(CCF0)
	{
		CCF0 = 0;
		i++;
		if(i >= tiempo) break;
	}
	EA = 0;
}
