ignaciosamba/PPS/Source/fuentes/interfaz.c

/**
 * @file interfaz.c
 * @author Sambataro, Ignacio; Mantovani, Luciano
 * @date 2015
 * @brief Funciones de interfaz de usuario e interpretacion de comandos
 * @details Este archivo contiene las funciones correspondientes a la obtencion y el procesado de los comandos ingresados por el usuario
 */

#include "headers.h"
#include "sensorCE/funciones_sensor.h"
#include "conversor.h"
#include "contador.h"
#include "interfaz.h"
#include "configurador.h"

/**
 * @brief Obtiene un comando
 * @details Se imprime un prompt, y luego de eso se espera que el usuario ingrese un comando con sus argumentos, si los hubiere. Tanto el comando como los argumentos son arreglos que pertenecen a la estructura shell, y son modificados y analizados por separado a nivel de caracter. Para la obtencion de ambos, se utiliza la funcion getchar()
 * 
 * @param shellstr la estructura de datos general. Utiliza los campos entrada, comando[], args[], y n_args
 * @return devuelve la misma estructura modificada.
 */
struct shellstr *obtener_entrada(struct shellstr *shell)
{
    char i = 0;
	// printf(">"); // imprime el prompt
    shell->report = 0;

    //recibe el comando
    while((shell->entrada = getchar()) != ',')
    {
        if((shell->entrada == '\n') && (i == 0)){ shell->report = 1000; return shell;}
        if(shell->entrada == '\n'){break;}

        if(i < TAM_COMANDO)  //la entrada debe ser menor al tamaño maximo de un comando
        {
            shell->comando[i] = shell->entrada;
            i++;
        }
        else shell->report = 404;
    }

    i = 0;

    //recibe los argumentos
    if(shell->entrada != '\n')
    while((shell->entrada = getchar()) != '\n')
    {
        if(i < MAX_ARGS)
        {
            shell->args[i] = shell->entrada;
            i++;
        }
        else shell->report = 405;
    }

    shell->n_args = i;
    // if(shell->n_args > 7)

    if(shell->entrada != '\n')
    while (getchar() != '\n');

	return shell;
}

/**
 * @brief Analiza el comando y toma una accion segun el mismo
 * @details Esta funcion debe ser ejecutada luego de "obtener_entrada". Cuando se ingresa el comando y los argumentos si los hubiere, y se ejecuta esta funcion, se analiza el contenido del comando y se ejecuta la funcion correspondiente, asegurandose antes de que no haya errores en los argumentos, siempre que los haya
 * 
 * @param shellstr la estructura de datos general. Utiliza los campos comando[], args[], n_args y report
 * @return devuelve la misma estructura modificada.
 */
struct shellstr *analizar(struct shellstr *shell)
{   
    if((shell->comando[0] == 'S') && (shell->comando[1] == 'T'))
    {
        shell->report = 254;
        shell->stop_conf = 0;

        return shell;
    }
    else if((shell->comando[0] == 'S') && (shell->comando[1] == 'S') && (shell->comando[2] == 'E'))
    {
        if(shell->n_args > 5)
        {shell->report = 405; return shell;}
        else if(shell->args[1] != ',' && shell->n_args < 2 || shell->n_args == 0)
        {shell->report = 407; return shell;}
        else if(shell->args[1] != ',' && shell->n_args >= 2)
        {shell->report = 408; return shell;}
        else if(shell->args[1] == ',' && shell->n_args < 3)
        {shell->report = 408; return shell;}
        else if(shell->args[0] - '0' < 0 || shell->args[0] - '0' > 7)
        {shell->report = 406; return shell;}
        else if( shell->n_args > 2 && (shell->args[2] - '0' < 0 || shell->args[2] - '0' > 9))
        {shell->report = 406; return shell;}
        else if( shell->n_args > 3 && (shell->args[3] - '0' < 0 || shell->args[3] - '0' > 9))
        {shell->report = 406; return shell;}
        else if( shell->n_args > 4 && (shell->args[4] - '0' < 0 || shell->args[4] - '0' > 9))
        {shell->report = 406; return shell;}
        else if( shell->n_args > 4 && ((unsigned)(atoi(shell->args + 2)) > 255))
        {shell->report = 406; return shell;}

        cargar_buffer_single(shell);

        return shell;
    }
    else if((shell->comando[0] == 'S') && (shell->comando[1] == 'D') && (shell->comando[2] == 'I'))
    {
        if(shell->n_args > 5)
        {shell->report = 405; return shell;}
        else if(shell->args[1] != ',' && shell->n_args < 2)
        {shell->report = 407; return shell;}
        else if(shell->args[1] != ',' && shell->n_args >= 2)
        {shell->report = 408; return shell;}
        else if(shell->args[1] == ',' && shell->n_args < 3)
        {shell->report = 408; return shell;}
        else if(shell->args[0] - '0' < 0 || shell->args[0] - '0' > 6 || (shell->args[0] & 1))
        {shell->report = 406; return shell;}
        else if( shell->n_args > 2 && (shell->args[2] - '0' < 0 || shell->args[2] - '0' > 9))
        {shell->report = 406; return shell;}
        else if( shell->n_args > 3 && (shell->args[3] - '0' < 0 || shell->args[3] - '0' > 9))
        {shell->report = 406; return shell;}
        else if( shell->n_args > 4 && (shell->args[4] - '0' < 0 || shell->args[4] - '0' > 9))
        {shell->report = 406; return shell;}
        else if( shell->n_args > 4 && ((unsigned)(atoi(shell->args + 2)) > 255))
        {shell->report = 406; return shell;}

        cargar_buffer_dif(shell);

        return shell;
    }
    else if((shell->comando[0] == 'G') && (shell->comando[1] == 'S') && (shell->comando[2] == 'E'))
    {
        if(shell->n_args > 1)
        {shell->report = 405; return shell;}
        else if(shell->args[0] - '0' < 0 || shell->args[0] - '0' > 7)
        {shell->report = 406; return shell;}

        get_single_ended(shell);

        return shell;
    }
    else if((shell->comando[0] == 'G') && (shell->comando[1] == 'D') && (shell->comando[2] == 'I'))
    {
        if(shell->n_args > 6)
        {shell->report = 405; return shell;}
        
        else if(shell->args[0] - '0' < 0 || shell->args[0] - '0' > 6)
        {shell->report = 406; return shell;}

        get_differential(shell);

        return shell;
    }
    else if((shell->comando[0] == 'S') && (shell->comando[1] == 'G') && (shell->comando[2] == 'A'))
    {
        if(shell->n_args > 1)
        {shell->report = 405; return shell;}
        else if(shell->args[0] - '0' < 0 || shell->args[0] - '0' > 7)
        {shell->report = 406; return shell;}

        else conf_ganancia(shell);

        return shell;
    }
    else if((shell->comando[0] == 'G') && (shell->comando[1] == 'T') && (shell->comando[2] == '0'))
    {
        if(shell->n_args > 0)
        {shell->report = 405; return shell;}

        else get_timer0();

        return shell;
    }
    else if((shell->comando[0] == 'G') && (shell->comando[1] == 'T') && (shell->comando[2] == '2'))
    {
        if(shell->n_args > 0)
        {shell->report = 405; return shell;}

        else get_timer2();

        return shell;
    }
    else if((shell->comando[0] == 'S') && (shell->comando[1] == 'H') && (shell->comando[2] == 'A'))
    {
        if(shell->n_args > 0)
        {shell->report = 405; return shell;}

        else mostrar_config_actual(shell);

        return shell;
    }

    else if((shell->comando[0] == 'G') && (shell->comando[1] == 'R') && (shell->comando[2] == 'P'))
    {
        if(shell->n_args > 0)
        {shell->report = 405; return shell;}

        else RPM_instantaneo();

        return shell;
    }
    else if((shell->comando[0] == 'C') && (shell->comando[1] == 'R') && (shell->comando[2] == 'P'))
    {
        if(shell->n_args > 0)
        {shell->report = 405; return shell;}

        else RPM_continuo();

        return shell;
    }

    else if((shell->comando[0] == 'P') && (shell->comando[1] == 'W') && (shell->comando[2] == 'M'))
    {
        if(shell->n_args > 0)
        {shell->report = 405; return shell;}

        else arrancar_motor();
        shell->report = 301;

        return shell;
    }

    else if((shell->comando[0] == 'N') && (shell->comando[1] == 'T') && (shell->comando[2] == 'P'))
    {
        if(shell->n_args > 0)
        {shell->report = 405; return shell;}

        else apagar_motor();
        shell->report = 302;

        return shell;
    }
    else if((shell->comando[0] == 'S') && (shell->comando[1] == 'L') && (shell->comando[2] == 'P'))
    {
        if(shell->n_args > 0)
        {shell->report = 405; return shell;}

        else habilitar_modo_bajo_consumo();

        return shell;
    }
    else if((shell->comando[0] == 'E') && (shell->comando[1] == 'S') && (shell->comando[2] == 'C'))
    {
        if(shell->n_args > 0)
        {shell->report = 405; return shell;}

        else resetear_motor();

        return shell;
    }
    else if((shell->comando[0] == 'C') && (shell->comando[1] == 'N') && (shell->comando[2] == 'F'))
    {
        if(shell->n_args > 0)
        {shell->report = 405; return shell;}

        else configurar_motor();

        return shell;
    }
    else if((shell->comando[0] == 'G') && (shell->comando[1] == 'O') && (shell->comando[2] == 'C'))
    {
        if(shell->n_args > 0)
        {shell->report = 405; return shell;}

        else generar_onda_cuadrada();

        shell->report = 303;
        return shell;
    }
    else if((shell->comando[0] == 'A') && (shell->comando[1] == 'M') && (shell->comando[2] == 'S'))
    {
        if(shell->n_args > 0)
        {shell->report = 405; return shell;}

        else arrancar_motor_sin_control();

        shell->report = 303;
        return shell;
    }
    else if((shell->comando[0] == 'E') && (shell->comando[1] == 'I') && (shell->comando[2] == 'N'))
    {
        if(shell->n_args > 0)
        {shell->report = 405; return shell;}

        else enable_int();

        shell->report = 303;
        return shell;
    }
    else if((shell->comando[0] == 'D') && (shell->comando[1] == 'I') && (shell->comando[2] == 'N'))
    {
        if(shell->n_args > 0)
        {shell->report = 405; return shell;}

        else disable_int();

        shell->report = 303;
        return shell;
    }
    else if(shell->comando[0] == 'p')
    {
        refresh_watchDog();
        shell->report = 501; // stillOn successful
        return shell;
    }

    else shell->report = 404;

    return shell;

}

/**
 * @brief Reporte
 * @details Esta funcion analiza el estado de la variable report, que esta dentro de la estructura shell, y 
 * segun ese valor imprime un mensaje en la pantalla, ya sea por un error o un acknowledge
 * 
 * @param shellstr la estructura general del programa, usa el parametro report.
 */
void reportar(struct shellstr *shell)
{
    switch(shell->report)
    {   
        case 251: printf("%05d", 251); break; // pin configurado en modo single-ended
        case 252: printf("%05d", 252); break; // pin configurado en modo diferencial
        case 253: printf("%05d", 253); break; // ganancia configurada
        case 254: printf("%05d", 254); break; // comienza la conversion continua
        case 301: printf("%05d", 301); break; // motor arranco
        case 302: printf("%05d", 302); break; // motor paro
        case 303: printf("%05d", 303); break; // onda cuadrada
        case 404: printf("%05d", 404); break; // comando no encontrado
        case 405: printf("%05d", 405); break; // demasiados argumentos
        case 406: printf("%05d", 406); break; // argumento(s) fuera de rango
        case 407: printf("%05d", 407); break; // error de sintaxis
        case 408: printf("%05d", 408); break; // error de sintaxis
        case 500: printf("%s", "0000.3000"); break; // stop succesful
        case 501: printf("%05d", 501); break; // stillOn successul
        case 502: printf("%05d", 502); break; // Inactive Server Stop
        case 0: break; // para el caso donde se apreta enter solo
        default: break;
    }

    return;
}

/**
 * @brief Reinicia los valores de los buffers del comando y los argumentos, preparandolos para recibir el proximo.
 * 
 * @param shellstr Estructura global
 */
void restart(struct shellstr *shell)
{       
    int i;
    for (i = 0; i < MAX_ARGS;i++)
        shell->args[i] = 0;
    for (i = 0; i < TAM_COMANDO;i++)
        shell->comando[i] = 0;
    shell->report = 0;
}
