ignaciosamba/PPS/Source/fuentes/headers.h

/**
 * @file headers.h
 * @author Sambataro, Ignacio; Mantovani, Luciano
 * @date 2015
 * @brief establece las librerias y define las variables que caen dentro del campo del funcionamiento del\
 * microcontrolador. 
 */
#include "C8051F350.h"
#include <stdio.h>
#include <stdlib.h>

#pragma ot(11, SIZE)  // optimiza la compilacion

#define SYSCLK      24500000           // SYSCLK Frecuencia del Clock en Hertz
#define MDCLK         2457600          // Frecuencia del clock del modulador (ideal = 2,4576 MHz)
#define OWR                300          // Output Word Rate deseado
#define BAUDRATE        9600          // Tasa de baudios de la UART
//-----------------------------------------------------------------------------
// 16-bit SFR Definitions for 'F35x
//-----------------------------------------------------------------------------
sfr16 TMR2RL = 0xCA;                   // Timer2 reload value
sfr16 TMR2 = 0xCC;                     // Timer2 counter
sfr16 ADC0DEC = 0x9A;                  // ADC0 Decimation Ratio Register


#define Byte3 0
#define Byte2 1
#define Byte1 2
#define Byte0 3


typedef union LONGDATA{                // Variable para acceder a un dato de 4 bytes de longitud como maximo
   unsigned long result;             
   unsigned char Byte[4];            
}LONGDATA;


typedef char byte;
#define ARRAYSIZE 8
#define MAXSIZE 50
#define TAM_SINGLE 12 			//define para tamaño de buffer! 


#define TAM_COMANDO 3
#define MAX_ARGS 8

typedef enum { false, true } bool;

// /*variables globales*/
// unsigned long dato_convertido;
// unsigned short pin_actual;

#define WATCHDOG_MOTOR 100


//////////-----BANDERAS------///////////

///bandera de dato convertido
extern bool f_dato_convertido;

///bandera de interrupcion de UART
extern bool f_UART;

///bandera de interrupcion de Timer3 (contador de RPM)
extern bool f_contRPM;

///bandera de sleep
extern bool f_sleep;
/// estructura general del programa que contiene los elementos principales del mismo. Al estar organizado en forma de estructura se facilita el pase de parametros, y mas aun si se inicializa como puntero a estructura
struct shellstr  
{   
	///cantidad de argumentos de la entrada
	char n_args; 
	///la entrada completa
	char entrada; 
	///comando de la entrada
	char comando[TAM_COMANDO]; 
	// char *comando; 
	
	///arreglo de argumentos. maximo 8
	char args[MAX_ARGS]; 
	// char *args; 

	///array variable para el conversor, al iniciar el adc, es igual a buffer_adc_count
	unsigned short int buffer_adc[TAM_SINGLE];  

	///array estatico que se carga para dar una frecuencia a las salidas del adc con buffer_adc
	unsigned short int buffer_adc_count[TAM_SINGLE];  
	
	///posicion dentro del array buffer_adc 
	short int posicion;				

	///numero de reporte
	short int report;

	///bandera de habilitacion de configuracion
	char stop_conf;

	///variable auxiliar para el indexado de buffer_adc
	char var;

	///variable auxiliar para las funciones get_single_ended y get_differential
	char opt;

	///variable booleana para saber si esta activa la conversion continua
	bool conversion_active;
};
