ignaciosamba/PPS/Source/fuentes/conversor.h

unsigned long convertir();
struct shellstr *conf_ganancia(struct shellstr *shell);
void cambiar_pin(void);
void enviar_dato(unsigned long int *);
char analizar_buffer(struct shellstr *shell);
void cargar_buffer_single(struct shellstr *shell);
void cargar_buffer_dif (struct shellstr *shell);
void get_single_ended(struct shellstr *shell);
void get_differential(struct shellstr *shell);
void actualizar_timestamp(unsigned short int);
