ignaciosamba/PPS/Source/fuentes/interfaz.h

struct shellstr *obtener_entrada(struct shellstr *shell);
struct shellstr *analizar(struct shellstr *shell);
void restart(struct shellstr *shell);
void reportar(struct shellstr *shell);

// void printeartodo(struct shellstr *shell);
