ignaciosamba/PPS/(commit log)

2015-04-20 Agregue datos.
    [.kicad_pcb.kicad_pcb, PPS1.kicad_pcb.kicad_pcb, adc.OBJ, prueba1.kicad_pcb, prueba1.sch]
2015-04-20 a ver que pasa
    [.kicad_pcb.kicad_pcb, PPS1.kicad_pcb.kicad_pcb, adc.OBJ, prueba1.kicad_pcb, prueba1.sch]
2015-04-20 Revert "a ver que pasa"
    This reverts commit 224125d209988b9207373ad34aa837af868d59f9.
    [.kicad_pcb.kicad_pcb, PPS1.kicad_pcb.kicad_pcb, adc.OBJ, prueba1.kicad_pcb, prueba1.sch]
2015-04-20 Revert "Revert "a ver que pasa""
    This reverts commit ce52e4edb60050e8a4856e37b82e109fdb21671b.
    [.kicad_pcb.kicad_pcb, PPS1.kicad_pcb.kicad_pcb, adc.OBJ, prueba1.kicad_pcb, prueba1.sch]
2015-04-20 borro los adc inservibles
2015-04-21 ultimo commit
    [adc.OBJ]
2015-04-21 Comentario
    Agregue comentarios en la parte del Swapeo.
2015-04-24 nuevos archivos
    despues de hacer los modelos de secuencia mas o menos chamulle los
    archivos que iriamos a tener y cree la carpeta de testing con un
    template y el .h que necesitamos para testear.. es una pelotudez yo lo
    use ya para otros trabajos se aprende a usar muy facil
    [adc.OBJ, adclucho.OBJ]
2015-04-24 puse un par de cosas en los archivos
    y cree el proyecto..
2015-04-27 cree el log para ir poniendo cosas
2015-04-27 puse un par de cosas mas a los fuentes
    silabs me lo compila pero tira warnings.. tengo que empezar a tirar
    magia...
    [adc.OBJ, comunicacion.OBJ, configurador.OBJ, interfaz.OBJ, main.OBJ, memoria.OBJ]
2015-04-28 compila
    ahora hay que ver si anda
    [adc.OBJ, comunicacion.OBJ, configurador.OBJ, conversor.OBJ, interfaz.OBJ, main.OBJ, memoria.OBJ]
2015-04-28 funciona tranca
    hicimos que andara el UART y puedo imprimir un par de cosas e
    interactuar con un usuario. estoy en mitad de armar toda la plataforma
    de los test para arrancar a escribirlos y despues hacer las
    funcionalidades
    [comunicacion.OBJ, configurador.OBJ, conversor.OBJ, interfaz.OBJ, main.OBJ, memoria.OBJ, test_comunicacion.OBJ]
2015-04-28 haciendo el test
    la idea es que test global corra todos los tests.. tengo que terminarlo
    pero me tengo que alzar al ogt. se vemo
2015-05-04 La plataforma de test ya esta andando
    [comunicacion.OBJ, configurador.OBJ, conversor.OBJ, interfaz.OBJ, memoria.OBJ, test_comunicacion.OBJ, test_global.OBJ]
2015-05-04 HAY
    bastantes quilombos internos.. pero se podria decir que va tomando
    forma. estoy cambiando el archivo interfaz.c para que tenga una forma de
    tomar los pines que siga el sentido comun.. pero se esta complicando..
    hay que empezar a hacer tests que verifiquen que anden las opciones de
    configuracion.. para el proximo commit deberian estar los tests hechos
    [comunicacion.OBJ, configurador.OBJ, conversor.OBJ, interfaz.OBJ, interrupciones.OBJ, memoria.OBJ, test_comunicacion.OBJ, test_global.OBJ]
2015-05-05 PRUEBA PARA VER SI NO SE ROMPE TODO
    [comunicacion.OBJ, configurador.OBJ, conversor.OBJ, interfaz.OBJ, interrupciones.OBJ, memoria.OBJ, test_comunicacion.OBJ, test_global.OBJ]
2015-05-05 Commit Prueba Archivos Placa
    [PPS1.kicad_pcb.kicad_pcb, PPS2.kicad_pcb, PPS2.sch, prueba1.sch, prueba2.kicad_pcb]
2015-05-05 una verga
    aca hay un intento del primer prototipo.. anda para el ojete basicamente
    porque no entiendo que pasa con las interrupciones.. hasta que no la
    tenga clara con los registros nunca voy a saber bien que pasa..
    [comunicacion.OBJ, configurador.OBJ, conversor.OBJ, interfaz.OBJ, interrupciones.OBJ, main.OBJ, memoria.OBJ]
2015-05-07 Cambio a convertir
    Cambio el dato_a_convertir a puntero
2015-05-07 Baud Rate 115200
    [comunicacion.OBJ, configurador.OBJ, conversor.OBJ, interfaz.OBJ, interrupciones.OBJ, main.OBJ]
2015-05-07 Envio dato sin puntero.
    [comunicacion.OBJ, configurador.OBJ, conversor.OBJ, interfaz.OBJ, interrupciones.OBJ, main.OBJ, memoria.OBJ]
2015-05-07 para probar con la fuente
2015-05-07 ADC andando con el MULTIPLEXOR.
    [configurador.OBJ, conversor.OBJ]
2015-05-07 esta incompletp
    esta la idea de hacer el array con la informacion de los pines single
    ended pero no esta implementado porque estuvimos 40 horas discutiendo de
    a donde y como hacer el array
    [conversor.OBJ, interfaz.OBJ, main.OBJ]
2015-05-08 SIN ERRORES
    Ya tiene hecho las funciones para multiplexar con el buffer pero no
    andando 100%
    [comunicacion.OBJ, configurador.OBJ, conversor.OBJ, interfaz.OBJ, interrupciones.OBJ, main.OBJ]
2015-05-08 Agregado un test
    agregue un test con el gain y un test para la configuracion que esta
    comentado hasta que salgan andando las cosas
2015-05-08 SIN ERRORES 2
    NO FUNCIONA NADA!
    [comunicacion.OBJ, configurador.OBJ, conversor.OBJ, interfaz.OBJ, interrupciones.OBJ, main.OBJ, memoria.OBJ]
2015-05-08 git ignore 2
    [comunicacion.OBJ, configurador.OBJ, conversor.OBJ, interfaz.OBJ, interrupciones.OBJ, memoria.OBJ, test_comunicacion.OBJ, test_global.OBJ]
2015-05-08 no se que pasa con los tests
    compila pero hay mil errores.. es todo una verga yo me voy al ojete
    [comunicacion.OBJ, configurador.OBJ, conversor.OBJ, interfaz.OBJ, interrupciones.OBJ, memoria.OBJ, test_comunicacion.OBJ, test_global.OBJ]
2015-05-11 prueba git ignore
    prueba para ver si desde ahora me deja de trackear los archivos que no
    quiero que esten en el repo
2015-05-11 a ver si ahi se arregla lo de los archivos que se siguen y me rompe las pelotas
    [adc.OBJ, adclucho.OBJ, comunicacion.OBJ, configurador.OBJ, conversor.OBJ, interfaz.OBJ, interrupciones.OBJ, main.OBJ]
2015-05-11 no anda nada
    el codigo esta tan roto que no se puede avanzar nada.. voy a hacer un
    commit con las ultimas cosas y voy a reconstruir todo con codigo viejo e
    ir avanzando a medida que anden cosas. es la unica manera
2015-05-11 commit para ver los cambios
    este comit tiene los archivos fuente del commit "ADC andando con el
    MULTIPLEXOR". quiero comparar ese con el ultimo commit.. osea "no anda
    nada" y ver que tocamos para que se rompa tanto todo
2015-05-11 Merge remote-tracking branch 'origin/master'
    Conflicts:
    .gitignore
    Placa/prueba1.lst
    Source/fuentes/adc
    Source/fuentes/adc.#1
    Source/fuentes/adc.#2
    Source/fuentes/adc.#3
    Source/fuentes/adc.M51
    Source/fuentes/comunicacion.#1
    Source/fuentes/comunicacion.#3
    Source/fuentes/comunicacion.LST
    Source/fuentes/comunicacion.M51
    Source/fuentes/comunicacion.OBJ
    Source/fuentes/configurador.LST
    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
    [PPS1.kicad_pcb.kicad_pcb, adc.OBJ, adclucho.OBJ, comunicacion.OBJ, configurador.OBJ, conversor.OBJ, interfaz.OBJ, interrupciones.OBJ]
2015-05-11 Funcionando la Interfaz para Single Ended.
2015-05-11 Anda como la SILVANA
2015-05-11 Tire alta fruta con el GANANCIA.
    No se si andara pero cambia la salida!! Nada modularizado, mañana
    tiramos la magia!!
2015-05-12 commit para sync
2015-05-12 cambio de archivos fuente
    se elimino control, porque las unicas funciones que tenian le incumbian
    nomas al adc entonces las incluimos en conversor y borramos las de
    control, se agrego un test en conversor.c que testea la funcion de
    cargar el array.. hay que seguir completando los tests
2015-05-12 se acabo la joda
    el compilador me dice que el codigo es muy grande para la version de
    prueba asi que comiteo esto y voy a buscar compiladores open source. una
    verga
2015-05-14 Arranque con la memoria
2015-05-14 Memoria 3
    hice algunos tests para verificar que las funciones de memoria que
    sacamos de las notas de aplicacion andan como parece que andan.
2015-05-14 commit para ver lo de la memoria
2015-05-15 Compilo
    ni probe si anda.. pero compila.. hay un error que estuvo dando vueltas
    que decia "space overflown" que me dejo de cara.. no se si nos estaremos
    quedando sin memoria.. un bajon
    [interfaz.c, main.c]
2015-05-15 para el orto
    anda todo bastante para la teta, y encima cuando se decide por compilar,
    me tira el error de address space overflow que me dejo de cara mal
    [conversor.c, conversor.h, headers.h, interrupciones.c, main.c]
2015-05-15 el proyecto anda, pero los tests no
    no se que pasa.. para mi no se esta acabando la memoria porque no tiene
    sentido!! no es tan largo el codigo.. algun moco estoy echando en algun
    lado que hace que no ande nada.
    buffer_single ahora ya no es mas un buffer sino un caracter de 8 bits..
    ahorra espacio.. lo hice para que no me rompa las bolas con la memoria
    pero ni pelota..el error sigue estando
    [conversor.c, conversor.h, headers.h, interfaz.c, main.c]
2015-05-18 compilan los tests
    ahi saque andando los tests.. no tengo ni puta idea de porque andaron..
    descomente un pedazo de codigo y volvio a andar a pleno ni idea pq la
    verdad.. me esta preocupando el tema del tamaño del codigo porque ya va
    por 4300 bytes mas o menos y tenemos 8K como maximo y nos falta
    bastante.. o achicamos codigo o trabajamos en assembler. ponele
2015-05-18 nuevo framework de test.. aver que pasa
2015-05-19 Fucking Diferential Mode!!!
    Ya anda el modo diferencial, lo probe con las celdas de carga! Solo
    queda arreglar un tema de como modificar un solo bit de un registro (bit
    AD0POL de ADC0CN) para no cagar la ganancia! VIVA EL PAPO!
    [configurador.c]
2015-05-19 commit1
    Hecho un OR con ADC0CN para modificar el ADP0POL y activar el
    diferential mode
2015-05-20 aaaaa como me vas a odiar con todos los cambios que hice. tremendo. pero saque un test andando y estoy chocho... ademas creo que estos cambios son para bien.. empece a usar estructuras asi que esta t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
2015-05-20 hice mas cagada aun.. espero que todo esto valga la pena bolos
2015-05-21 saque andando los tests de interfaz y agregue un pequeño handler de errores para extender en algun momento
    [test_interfaz.c]
2015-05-22 compila pero no puedo probarlo
    acomode todos los archivos a los cambios que hice y con todas las
    funciones logicas testeadas.. como el tragaleche de sambataro esta
    probando cosas con la placa no puedo probarlo todavia. los archivos
    comunicacion, memoria e impresiones no se usan mas.. interfaz_viejo no
    se usa.. lo deje ahi por que estan las funciones viejas por las dudas
2015-05-22 cambie un par de cosas pero mepa que al micro se le arma quilombo con los punteros
2015-05-29 committ
    cambis de antes de irme el martes pasado y cambios que hice ayer.
2015-06-02 arrancando con los timers
2015-06-04 FUNCIONAAA!!!!
    El contador, funciona, la concha de tu madre all boys!
2015-06-04 TIMER CEROOO
    ahi esta hecha la funcion para pedir el valor del contador.. por ahora
    el timer 0 esta como un contador de 16 bits. estaria bueno en un futuro
    tenerlo como 2 contadores de 8 bits, y junto con otros contadores sumar
    4 contadores de eventos.
2015-06-05 TIMER 2 Y TIMER 3
    sume al proyecto las funciones para configurar timer2 y 3.. pero creo
    que timer 3 nos lo vamos a tener que meter por el orto poruqe la fuente
    externa que elige es la misma que la de timer 2 asi que basicamente van
    a contar lo mismo.. por lo que no sirve.. lo que pienso es usar el PCA y
    dejar al timer 3 como un contador interno para alguna otra cosa que haga
    falta. el archivo contador.c en timer tiene todo implementado para hacer
    andar el timer 2
2015-06-12 cambie algunas cosas para el PCA
    pero el PCA sigue sin andar.. algun dia andara. ahora sale flash
2015-06-12 flash
    hice varias cosas de la flash, estan los comandos para cargarla,
    modificarla, etc.. soy un pelotudo porque tendria que haber hecho un
    commit cuando tenia hecha bien la escritura porque ahora no me escribe y
    no se porque
2015-06-12 flashhhh
    bueno logre que escriba pero por alguna razon despues de la escritura se
    crashea el programa zarpado.. algun moco estoy mandando
2015-06-15 FLASH ANDANDO
    en teroria estaria andando.. esta escribiendo los datos en la direccion
    0x01F0 que esta dentro de la primera pagina de la flash, que es de
    datos. no hay nada en esa ultima franja asi que estamos escribiendo en
    la nada misma lo cual no deberia traer problemas.. pero igual estamos
    usando como zona temporal la 0x1A00 que en cualquier momento empieza a
    ser parte de codigo asi que no creo que dure mucho. alta fe
2015-06-18 el log es lo unico que vale la pena leer!!
2015-06-18 arreglado el git ignore
2015-06-18 FUUUCK
    queriendo arreglar que cuando pones enter no imprima el error, detone
    los comandos sin parametros.. no hay drama seguro es una boludes. pero
    me tengo que ir. se vemo
    [interfaz.c, main.c]
2015-06-19 AHI ARREGLE
    bueno no tira mas error cuando pones solo enter. ahora hago este commit
    para ya cambiar el adc para siempre muajaja
    [interfaz.c]
2015-06-19 arranque con el nuevo adc
2015-06-19 se estaba subiendo el hex asi que lo agregue al ignore
2015-06-23 ahi esta el primer prototipo del nuevo adc
    basicamente se llego a lo mismo del primer prototipo, nomas que imprime
    todo junto con los valores de los pines diferenciales tambien. hay que
    hacer el buffer con contador para que no imprima todo siempre
2015-06-23 zarpado
    bueno hice andar casi todo... los contadores en el buffer andan.. tuve
    que hacer un buffer nuevo. ahora los buffers tienen enteros y no
    caracteres porque si no no se van a bancar nada.. aunque por lo que
    puedo ver es bastante verga la velocidad del adc, y ademas hay que
    arreglar algun problema en el algoritmo porque cuando pongo SSE,3X me
    imprime una pata diferencial que nada que ver.. algo mal hice en algun
    lado.. me voy a la bostta
    [interfaz.c, main.c]
2015-06-25 ahi anda mejor
    va queriendo, ya no confunde las patas.. pero falta ponerle un poco de
    deteccion de errores al SSE nuevo y habilitar el seteo de patas
    diferenciales con SDI
    [main.c]
2015-06-25 un bajon
    en algo la esta cagando la funcion cambiar_pin() porque sin esa funcion
    las patas miden excelente y con esa funcion miden para el traste.. ni
    idea que podra ser pero anda muy para atras
2015-06-26 ahi anda bastante bien la conversion
    habia que poner el adc en modo idle antes de cambiar adc0mux. ahora no
    se porque no anda bien en el modo sse,01 pero ya voy a ver que pasa.
2015-06-29 volvieron los testss
    hice los tests de hardware haciendo un test completo entero de pecho..
    que se llama test_conversor
2015-07-01 ahi se puede configurar el modo diferencial
    anda medio para la chota pero bueno.. que se puede esperar si medis aire
2015-07-01 mas cosas
    subi un par de cosas.. estoy tratando de que se pueda volver al menu
    desde la impresion de las conversiones.. pero esta duro.. hice un par de
    tablas en excel y actualice el log. me voy al orto
2015-07-10 documentacion y testing
    agregue el doxygen para documentar y estoy haciendo mas testing para
    poder probar bien el hardware de la placa nueva
2015-07-10 ahi andan los tests basicos
    separe el de blink led con el del resto porque es un test muy basico..
    es el primero que se tiene que probar y deberia estar separado
2015-07-22 refactory
    cambie los nombres de los archivos.. volvi a juntar los archivos hw y
    logic en uno solo ya que deje de testear en linux y ahora testeo todo
    desde el uvision
2015-07-22 mas refactory
    cambie los headers de los tests. pero por alguna razon lo probe y no
    imprime nada en el realterm
2015-07-22 bug fix
    habia borrado sin querer una linea de codigo que no dejaba que arranque
    la obtencion de la entrada. ahi la volvi a poner y volvio a andar
    [main.c]
2015-07-22 Parar ADC con UART
2015-07-22 sacando la basura
    saque archivos que ya no usamos
2015-07-22 vevo vee
    se puede parar la conversion y volver al inicio
2015-07-23 cambio y error
    quise hacer un cambio re estupido en la interfaz para que imprima una
    giladad cuando pongo ST y me di cuenta que de pecho dejo de andar la
    configuracion de diferencial.. algo habre hecho
    [interfaz.c, interrupciones.c]
2015-07-28 blink led
2015-07-31 agregue funciones
    agregue dos funciones para que estando en la interfaz de usuario se
    pueda pedir un dato de conversion inmediato.. onda lo mismo que con los
    timers.. adquisicion por demanda.. falta probbarlos
2015-08-21 Esto ya es tesis, agregue el contador de RPM
2015-08-21 arreglando bugs
    hay un bug en el modo diferencial, lo puedo setear pero no arranca la
    conversion. lo veo el lunes
    [interfaz.c]
2015-08-25 ahi anda el tema de las rpm
    ahi mide mas o menos bien las rpm con una presicion de 30 rpm que esta
    limitada por la cantidad de aspas. deje a la mitad un test que prueba
    todas las operaciones
2015-08-25 saque por completo la flash
    como no la usamos porque es una porqueria las cosas que hace teniendo
    tan poca memoria, la sacamos al carajo y vamos a buscar otra manera de
    guardar la configuracion.. estoy probando el test de la interfaz pero no
    sale bien
2015-08-26 cambie de lugar las cosas nomas
    hay que agregar una funcion en el archivo nuevo creado que haga el
    generador de pulsos que hace arrancar el motor. Es el mismo programa
    que esta en arduino nomas que hay que hacerlo en la f352
2015-09-02 va queriendo
    hay que probarlo con la placa de parlanti que la tienen los otros
    culiados asi que no puedo probar nada hasta no tenerla
2015-09-08 armando la funcion de arrancar el motor
    por ahora sigue sin andar.. por alguna razon no interrumpe nunca
2015-09-09 el timer anda, pero mal...
    voy a tratar de hacerlo con el timer en modo 8 bit en vez de 16
2015-09-10 ahi anda y se queda estable, pero...
    hay una forma mucho mas facil y rapida de hacer anda todo y es usando el
    puto modulo de pwm que tiene la silicon labs que me acabo de enterar que
    tiene... asi q cambio todo
2015-09-10 este es el pwm del ejemplo de silabs
2015-09-10 ahi anda mortal
    ahora lo que hay que ahcer es calibrar los tiempos de ciclo de trabajo
    para que hagan andar al driver.
2015-09-11 arranco
    tenia la fuente limitando la corriente que pelotudoo
2015-09-14 ahi esta el modulo de pwm integrado al embebido
    deberia andar, no lo pobe aun
2015-09-14 ahi anda el pwm
    pero por alguna razon me rompe todo el resto del codigo no se xq
2015-09-17 ahi parece que andaria
    hay un problema con las interrupciones del PCA.. si las deshabilito anda
    todo.. queda probar si anda bien el PCA, que no creo.. pero ya te juro q
    todo es posible
    [configurador.c, configurador.h, interfaz.c]
2015-09-17 cambio en PCA y git ignore
    le agregue un par de cosas a la funcion set_pwm y la de arrancar motor
    para que funcione con interrupciones, aunque por alguna razon esta
    andando (ya probamos) sin habilitar las interrupciones... osea es muy
    extraño pro bueno anda.. ahora le pongo esto a ver que onda
2015-09-17 funcion de control
    hice una funcion de control para ver si se mantienen mejor las RPM.. no
    la pude probar todavia porque me sacaron la fuente.. mañana la pruebo
2015-09-18 va queriendo
    no se que onda porque habia un problema con la resolucion y el calculo
    que se hace en la conversion.. pero deberia estar bien.. voy a seguir
    probando
    [conversor.c]
2015-09-21 volvio a andar el pwm
    le saco las interrupciones porque anda sin interrupciones no tiene
    sentido que no tenga las interrupciones pero si le pongo las
    interrupciones anda para el orto. asi que le saco las interrupciones
2015-09-21 cambio en GSE, GDI, y en interfaz
    arregle gse que ahora anda, y en gdi le saque la excepcion por numeros
    impares.. que hay que hacer de vuelta pero bien.. tambien gdi anda medio
    mal todavia porque no imprime bien los numeros no se porque. le deje
    algo codificado que no se si anda porque no tengo la placa con migo
    [conversor.c, interfaz.c]
2015-09-22 con la division de mV anterior
2015-09-22 asi como esta el codigo ahora, anda una belleza
    anda todo, anda el adc, andan los timers. anda todo la concha de la lora
    y viva el papo
2015-09-22 arreglando bugs y haciendo mas tests
    arregle el bug para SDI, GSE y GDI, y agregue tests para SSE y la
    interfaz
    [conversor.c, interfaz.c, test_obtener_entrada.c, test_sse.c]
2015-09-23 agregue tests, y agregue la carpeta de informes
    [tablas.xlsx]
2015-09-23 Primera aproximacion de SAMBA a latex!
    Descripcion de HARDWARE
2015-09-25 segundo release
    ya vendriamos teniendo todo listo.. termine todos los tests y verifique
    que ande todo bien con la placa y todo.. asi que ya estaria lista la
    parte de todo lo que es la concentradora y las funciones para el motor.
    nomas esta el detalle del control de velocidad que hay que calibrarlo
    para que no oscile tanto. pero el resto esta. desde aca saco un branch
    que es para que ande todo con el modulo de comunicacion de gaston y juan
2015-09-25 modifique los prints
2015-09-25 Diseño de Hardware. Avances del Hardware. Construccion del Hardware.
    todo en latex.
2015-09-25 ahi anda la conversion diferencial pero no los get
2015-09-25 llegan las cosas y anda bien
    hay que hacer cambios con respecto a los caracteres que recibe y los que
    envia.. hay que ver que me dice gaston sobre lo que mas conviene para el
    modulo wifi. se vemo
2015-09-28 anda todo sin control de rpm
2015-09-29 control de velocidad
    estoy cambiando las cosas para que el control de velocidad este activo
    siempre, pero no estaria andando muy bien.. por ahora realimenta
    positivamente pero me parece que es un problema del contador de eventos
    [configurador.c, conversor.c, funciones_sensor.c, funciones_sensor.h, interrupciones.c, main.c]
2015-09-29 anda medio raro
    me parece que la baja de presicion que le hice de pasar a medir cada
    500ms a 100ms hace que se rompa todo.. voy a probar una cosa pasando a
    medir rps en vez de rpm cualquier cosa multiplico por sesenta para
    imprimir
2015-09-29 que pelotudo. EPIFANIA
    me acabo de dar cuenta de que realmente soy a pila. le vengo haciendo el
    control de velocidad al motor teniendo en cuenta las RPM, siendo que los
    datos que me da el contador son mucho mas crudos y precisos que los que
    tengo una vez hechas todas las cuentas para las RPM.. como le voy a
    hacer el control ya calculadas las RPM???? se lo tengo que hacer
    antes!!!!!! con los datos posta!! no despues de modificar todo..
    tremendo
2015-09-29 anda mejor ahi
    le cambie para que el control sea basado en las vueltas cada 100
    milisegundos y no en rpm como hacia antes tab brutamente.. pero igual
    sigue medio inestable.. hay que ver que pasa
2015-10-05 anda con rele y todo
    parece ser que anda todo bien... el motor no se desestabiliza demasiado
    y pude hacerlo andar con un rele.. ahora falta hacerlo andar con los
    modos de bajo consumo
2015-10-05 agregue funciones para los modos de bajo consumo
    cada funcion tiene retornos de tipo acknowledge que se envian por UART.
    800 = bajo consumo habilitado
    801 = bajo consumo inhabilitado
2015-10-07 algunos ajustes menores
    le cambie la salida para que envie siempre 5 caracteres. cualquier
    respuesta va a ser de 5 caracteres.
2015-10-16 agregue los modos de bajo consumo
2015-10-23 a ver si arranca de nuevo el motor
2015-10-29 arreglando y comprendiendo el motor
    [configurador.c, funciones_sensor.c, funciones_sensor.h, headers.h, interfaz.c]
2015-10-29 ahi tome las medidas y las puse en el log.
2015-10-29 sinqueando por el letexxx
2015-11-02 metiendole al informe de 100 horas
2015-11-03 informe completo casi casi
    hice un archivo nuevo para poder hacer la correccion ortografica toda
    junta porquue no me estaba andando el paquete de inputenc de latex que
    me dejaba poner los acentos.. creo que ya se mas o menos porque y me
    entere mientras hacia este archivo asi que en el proximo vuelvo todo
    como antes.. falta nomas de agregar un par de imagenes y el diagrama de
    bloques de los circuitos y verificar que este todo bien
2015-11-06 ya casi el informee culiaa
2015-11-06 avances de hardware
2016-03-10 volviendo de las vacaciones. empece el informe de las 200 horas y agregue un par de imagenes. no cambie nada del codigo pero lo compile una vez mas para ver que onda y parece que anda todo bien. ahor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
2016-03-10 cambie algunas cosas para que ande bien con el servidor.. ya no hay que usar mas la x para separar entre los argumentos sino que se usa directamente la coma, y todas las cosas que devuelve el sistema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
2016-03-10 me olvide de hacer stage files en el commit anterior
2016-03-21 Agrego Carpeta con las placas y las librerias de kicad que me hacen Falta
    [Operacional.kicad_pcb, Operacional.sch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]
2016-04-01 nuevo proyecto creado con uvision3 porque no consegui el crack para el 4 y este anda joya
    [serial.ino]
2016-04-04 le agregue el stillOn a la conversion continua. de ahora en mas se para la conversion enviando una s y se pide un stillOn enviando una 'p'
2016-04-07 la funcion de keepAlive esta andando a pleno. faltaria agregarle algo para deshabilitarla porque anda siempre
2016-04-19 Agrego el Informe Con Compilacion Andando
    Descargue todos los archivos desde el OverLeaf, esta andando, hay que
    revisarle la ortografia, porque OverLeaf habla castellano peor que
    ralph!
2016-05-04 hay un monton de cosas nuevas.. pero la razon por la cual commiteo es por los test cases en excel nuevos.. para que los veas.. espero que esto no rompa absolutamente todo
    [Excel template.xlsx, Prender motor.xlsx, Probar conectividad.xlsx]
2016-05-04 tutorial base de datos
2016-05-10 Agruegue Funciones para usar el Buffer
    Puse que con cuando el productor recibe un e empiece a mandar recien,
    hasta entonces solo guarda las conversiones en un buffer.
2016-05-13 CAMBIOS EN AGUNAS COSAS
    [Excel template.xlsx, Prender motor.xlsx, Probar conectividad.xlsx]
2016-05-23 revert de los sources cambiados del sistema 8051 y agregado de un diagrama se secuencia mas
    [headers.h, interfaz.c, main.c]
2016-06-06 no anda el timestamp. voy a probar otra manera pero commiteo para guardar por las dudas
2016-06-08 anda el timestamp. da un numero crudo que representa el tiempo que paso desde el ultimo reset a 0 del contador del timestamp. El numero solo tiene sentido unicamente teniendo el timestamp de la medic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
    [configurador.c, conversor.c, conversor.h, interrupciones.c, main.c]
2016-06-13 cmabio en la respuesta del stop continuous conversions. ahora devuelve '03000'
2016-06-14 actualizacion de diagramas en el enterprise. agregue tambien unos txt con los requerimientos del sistema
2016-06-15 nuevo diagrama de bloques fisicos del sistema de adquisicion
2016-06-16 agregue diagrama de bloques de sistema fisico para el sistema de procesado y guardado
2016-07-22 Cambios de onda
2016-09-18 refactorizado de los comentarios y cosas nuevas
2016-09-20 diagrama para la prueba de campo
2016-10-07 diagrama de actividad para analizar buffer
2016-10-10 diagrama de bloques para el sensor
2016-10-11 diagrama de actividad de la interfaz
2016-10-21 diagrama de secuencia para la marca de tiempo
2016-10-22 no se que bosta hice ni me acuerdo
2016-10-25 diagramas del sensor
2016-11-21 diagrama cambiar pin primera iteracion
2016-12-01 cambie el formato de envio
2016-12-06 diagrama de bloques del sistema de gestion y diagrama de interaccion entre el sistema de gestion y la plataforma de instrumentacion
2017-03-03 dibujo de sensor nuevo
    [sensorNuevo.skp]
2017-03-03 mas dibujos del sensor nuevo
    [sensorNuevoed2.skp]
2017-03-03 me falto el vertical
2017-04-24 modficaciones al programa para el sensor nuevo
2017-09-07 funciones sensor
2017-10-20 cambios en funciones sensor
